NikitaSardesai/AERO3760-Space-Engineering-2/PCBlayout/README.txt

A rough layout of the pcbs physical location within the structure
