NikitaSardesai/AERO3760-Space-Engineering-2/PDR TeX/StructuralDesign.tex

%\section{Structural Design}
%The proposed one-unit satellite structure will be 3D printed using ABS plastic. This method was chosen in preference of an aluminium chassis primarily because of the ease of access of production.
