NikitaSardesai/AERO3760-Space-Engineering-2/PDR TeX/titlepage.tex

\begin{titlepage}

\thispagestyle{empty}
\begin{center}
\begin{minipage}{\linewidth}
    \centering
%University logo
    
    \par
    \vspace{1.2cm}
    {\textsc{School of Aerospace Mechanical and Mechatronic Engineering \\ \vspace{0.3cm}
            AERO3760: Space Engineering 2}}
   \vspace{0.7cm}
%Thesis title
	\hrule
    \vspace{1.5cm}
    {{\LARGE\roboto{ SnapSat Preliminary Design Report }\par}}

    \vspace{1.5cm}
    \hrule
    \vspace{1.3cm}
     {\large \textsc{21 August 2015}}
\vspace{1.3cm}
%Author's name
    \begin{table}[H]
        \centering
        %\caption{Team Member Details and Contributions}
        \vspace{0.2cm}
        \label{tab:maxturbulencealpha}
        {\renewcommand{\arraystretch}{1.7}%
            \begin{tabular}{|>{\centering\arraybackslash}m{6cm}|>{\centering\arraybackslash}m{9cm}|}
                \hline
                \textbf{Name and Email} & \textbf{Role and Responsibility} \\ \hline\hline
                James Allworth | 312073038  jall8741@uni.sydney.edu.au & \textit{Attitude Determination and Control System} \newline pointing budget  \\\hline
                Thomas Forbutt | 312101058  tfor8012@uni.sydney.edu.au & \textit{Communications and Data Handling} \newline link and data budgets - component selection \\\hline
                Oscar McNulty | 312106130  omcn3220@uni.sydney.edu.au & \textit{Structural Design and Development} \newline structural simulations and development \\\hline
                Penelope Player | 312106718  ppla7388@uni.sydney.edu.au & \textit{On-board Computer and Power System} \newline schematic and power budget - component selection - power system selection \\\hline
                Nikita Sardesai | 312088205  nsar2497@uni.sydney.edu.au & \textit{Thermal System Design and Payload} \newline mass budget thermal design - stemn page management \& report structure \\\hline
                \end{tabular} } 
        \end{table}
    
%    \vspace{1.8cm}
%    {\large\roboto{ Abstract}}
%    \vspace{0.4cm}
%    \justify
%    {\begin{spacing}{1.3} \lipsum[10] \end{spacing}\par}
\end{minipage}
\end{center}

\end{titlepage}
