NikitaSardesai/AERO3760-Space-Engineering-2/PDR TeX/Introduction.tex

\section{Introduction}
SnapSat is a design solution as a part of the AERO3760: Space Engineering 2 course at the University of Sydney. The project involves specific design specifications as set out by the course administrator and the CubeSat requirements~\cite{specification}. This report details the selected mission and preliminary design considerations. Satellite components will be purchased off the shelf, where financially viable. Otherwise, components will be made in-house. Over the course of the project development, components will be tested separately and a series of final testing will be conducted once assembly is completed. SnapSat will undergo vibration testing, vacuum testing, communications and power testing and the attitude determination and control system will be tested on an air-bearing table.
