NikitaSardesai/AERO3760-Space-Engineering-2/Presentations/SnapSat CDR Presentation.pptx

## SnapSat

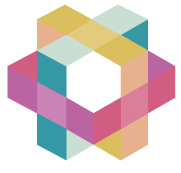
[picture p25: figure]

Critical Design Review
6th November 2015

Notes: Good Morning etc.

## Meet the Team

- James Allworth – Attitude Determination and Control
- Thomas Forbutt – Communications and On-board Data Handling
- Oscar McNulty – Structural Design and Development
- Penelope Player – On-board Computer and Power System
- Nikita Sardesai – Thermal Control and Payload

SnapSat Critical Design Presentation

Notes: First lets start by introducing the team. If you have any questions, feel free to ask.

## Our Mission

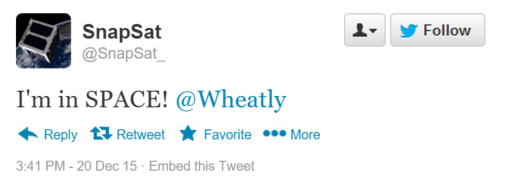
[picture p26: figure]

To bring space to YOU

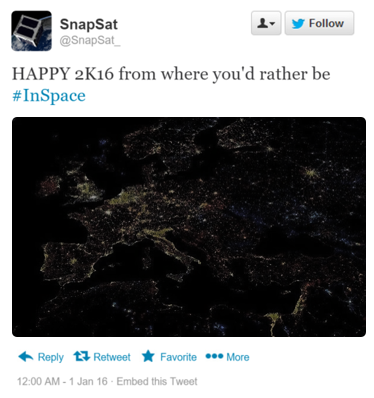
[picture p27: figure]
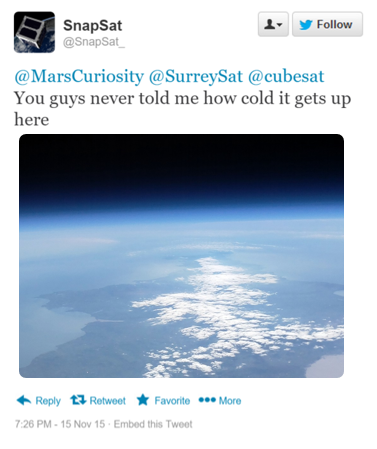
[picture p28: figure]

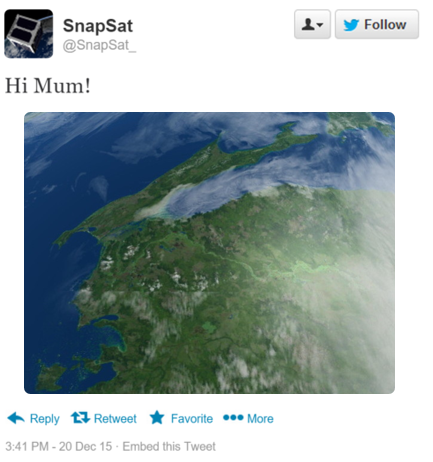
[picture p29: figure]

Notes: So what’s out mission? SnapSat is destined to be a satellite that is directly accessible to you!
SnapSat is a nano-satellite designed for outreach and space accessibility for educational bodies and the general public. In a sun-synchronous orbit at an altitude of 350km, SnapSat will be in the prime position of Earth observation. Users can send a message to the cubesat, which will take beautiful images of the Earth and tweet it to the world.
SnapSat will relay position data, so users are able to take photographs where they please. There is also scope for the development of a desktop/phone application for direct user connection to the satellite via groundstation.
Following the success the final build and launch, the team is hoping to lunch SnapSat on a sounding rocket - where it will stay in a LEO for about 3 months, taking beautiful photographs!

For example (These are hypothetical and not images taken with SnapSat. However, these are indicative of the quality of photos we are hoping to achieve):

SnapSat will relay position data, so users are able to take photographs where they please. There is also scope for the development of a desktop/phone application for direct user connection to the satellite via groundstation.

## Design Point

- 1U Cubesat
- $1000 budget
- 13 week timescale
- Design for balloon launch to 30km
- Communications: 5-node networking scheme

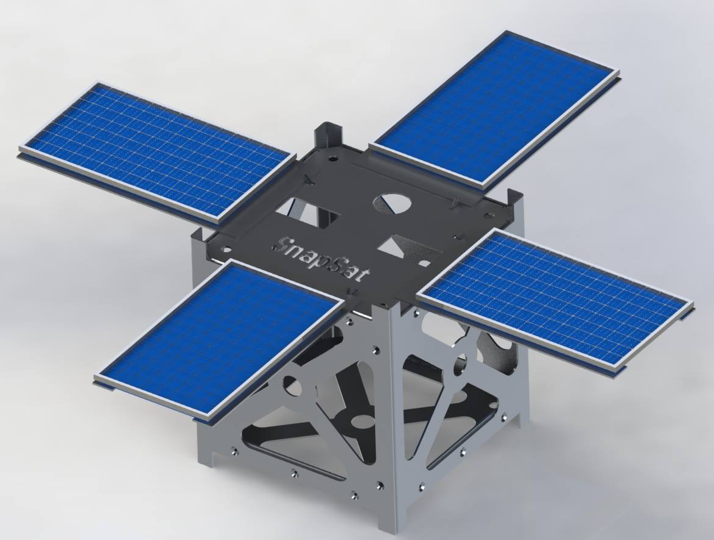
[picture p30: figure]

Figure 1 – Preliminary Design
(this has since been improved upon)

## Operation Overview

- Component Selection and Operation

## Component Selection

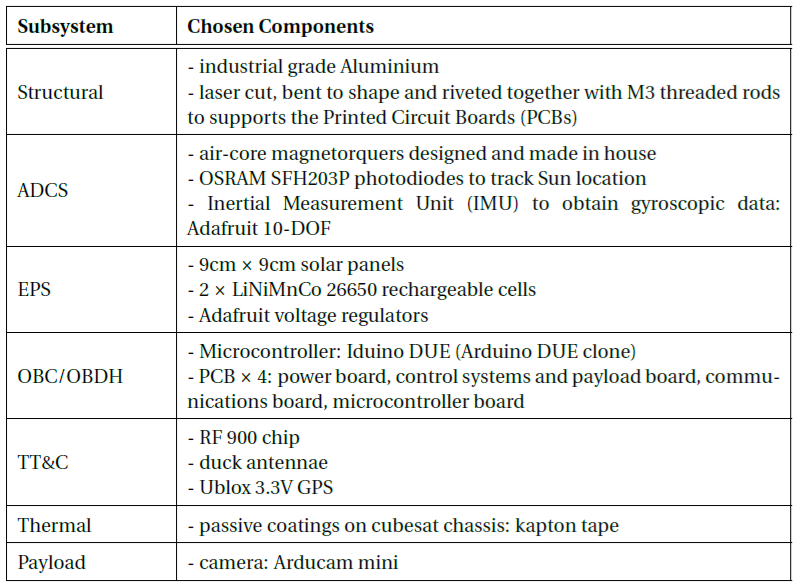
[picture p31: figure]

## System Interaction


## Structural Design

- Oscar McNulty

## Final Design

## FEA Test Methodology

- Natural Frequency
- Sinusoidal Sweep
- Random Frequency
- Quasi-Static

## Mass Budget

Subsystem | Component | Mass + Contingency | Fraction of total mass
Structural | Chassis – Laser cut Aluminium Solar Panels | 435 g | 47.6%
ADCS | Air core coils (in house) Osram photodiodes Adafruit 9DOF IMU | 180.2 g | 22%
EPS | Batteries & Power bus | 122 g | 14.9%
OBC / OBDH | Arduino DUE board Memory storage | 31.2 g | 3.8%
TT&C | Antennae VHF/UHF receivers/transmitters | 84 g | 10.3%
Thermal | Heat taping, Kapton tape Multi-layer insulation | 4.8 g | 0.6%
Payload | TTL Camera | 25 g | 3.1%
Integration | Wires, bolts and cables | 9.5 g | 1.2%

## Mass Balance & Total Weight

Subsystem | Total Weight | Distance From Centroid | Inertial Contibution
Structural
ADCS
EPS
OBC / OBDH
TT&C
Thermal
Payload
Integration

## Attitude Determination and Control (ADCS)

- James Allworth

## Attitude Determination

- GPS
- IMU
- Sun Sensors

## Attitude Control

- GPS
- IMU
- Sun Sensors
- Magnetorquers
- Control System

## Magnetorquer Design

## Control System Design

## Electrical Power System (EPS)

- Penelope Player

## System Specifications

- Components
- Charging Circuit
- Voltage Rails
- Battery Lifetime

## Power Budget

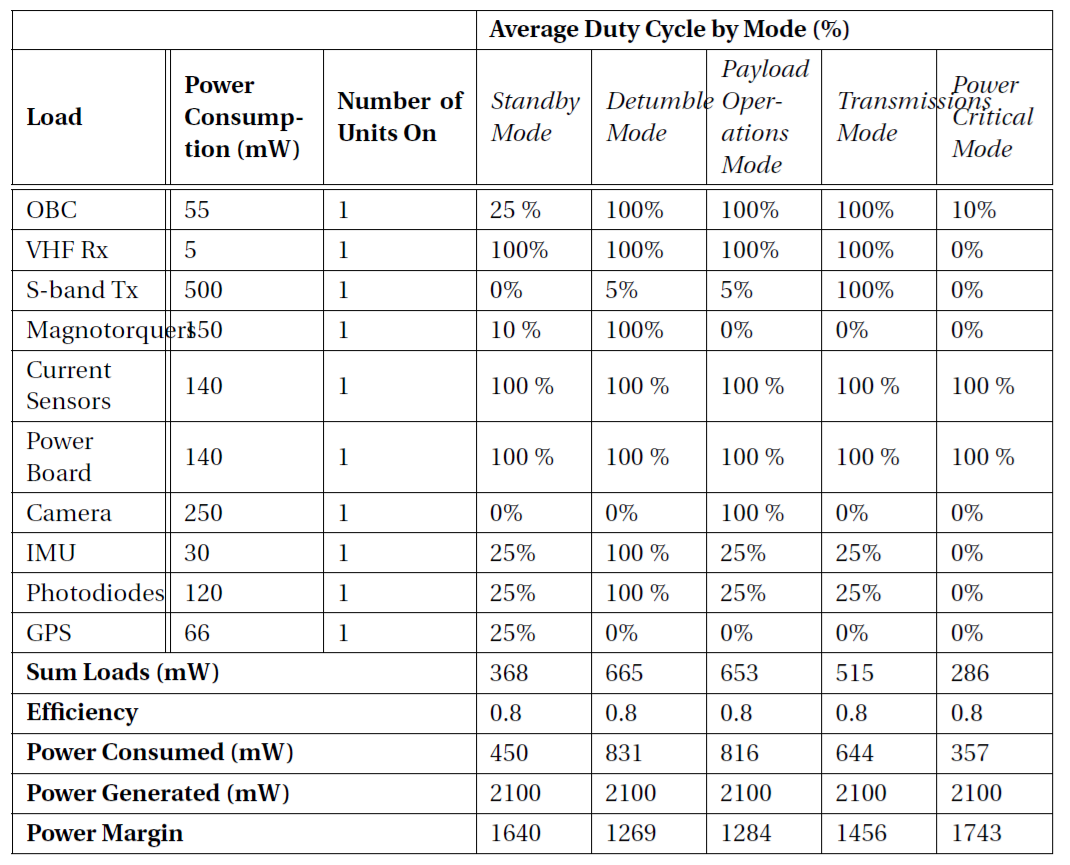
[picture p32: figure]

## On-Board Computer and Data Handling (OBC/DH)

- Penelope Player

## System Interactions

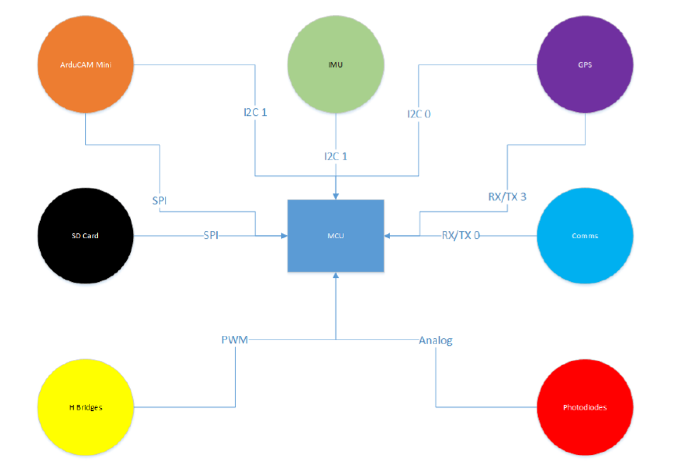
[picture p33: figure]

## Communications

- Thomas Forbutt

## Components and Specifications

- details

## Five-Node Network Setup

- details

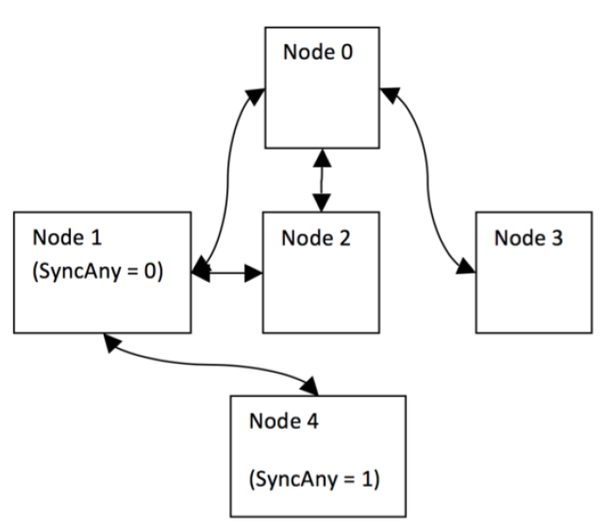
[picture p34: figure]

## Thermal Control

- Nikita Sardesai

Note to snapsat: (this section is a bit too long – I will cut it down!)

## Space Thermal Dynamics

- Model specified for 3 month, 350km orbit
- Simplified mass: system dissipating heat to boundary exposed to space
- General governing equation

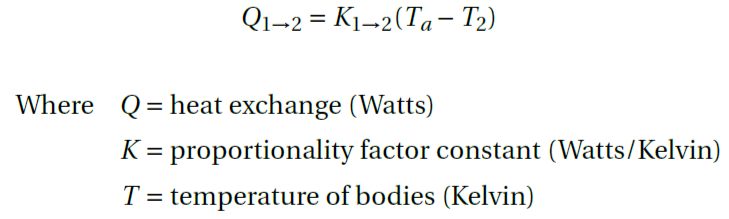
[picture p35: figure]

Notes: Go though component selection

Note: we were able to achieve such a high mass budget since expesive, space rated and optimised componenet were selected.

## Space Thermal Environment

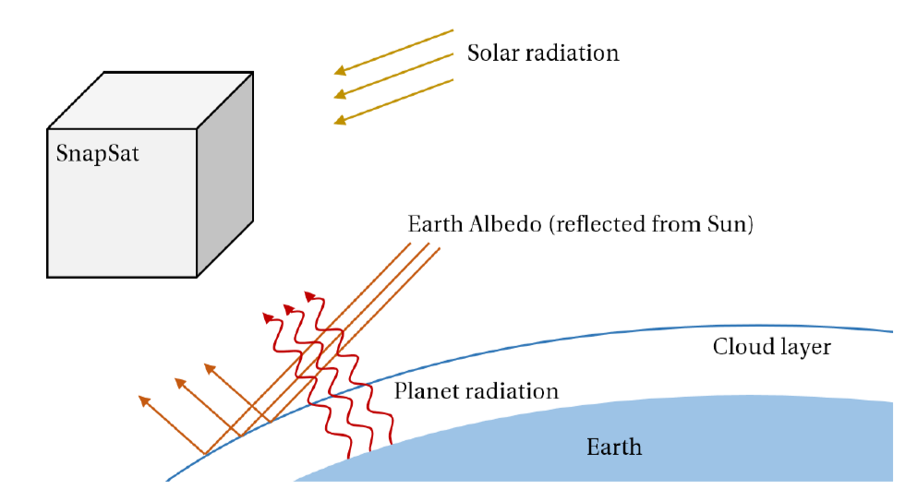
[picture p36: figure]

Notes: Go though component selection

Note: we were able to achieve such a high mass budget since expesive, space rated and optimised componenet were selected.

## Heat Transfer Modes

- Heat flux relates to a change in temperature as
- Three modes:
  - Conduction
  - Convection (not relevant)
  - Radiation

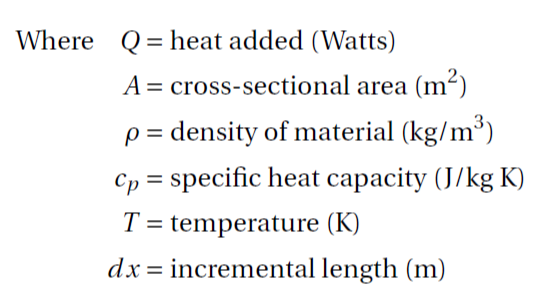
[picture p37: figure]

Notes: Go though component selection

Note: we were able to achieve such a high mass budget since expesive, space rated and optimised componenet were selected.

## Total Incoming Radiation

- Specification: sun-synchronous, 66% of orbit time spent in the sun, 98° inclination
  - Simulated orbit was rotated 45° about the z Earth-body axis and 8° about the y Earth-body axis

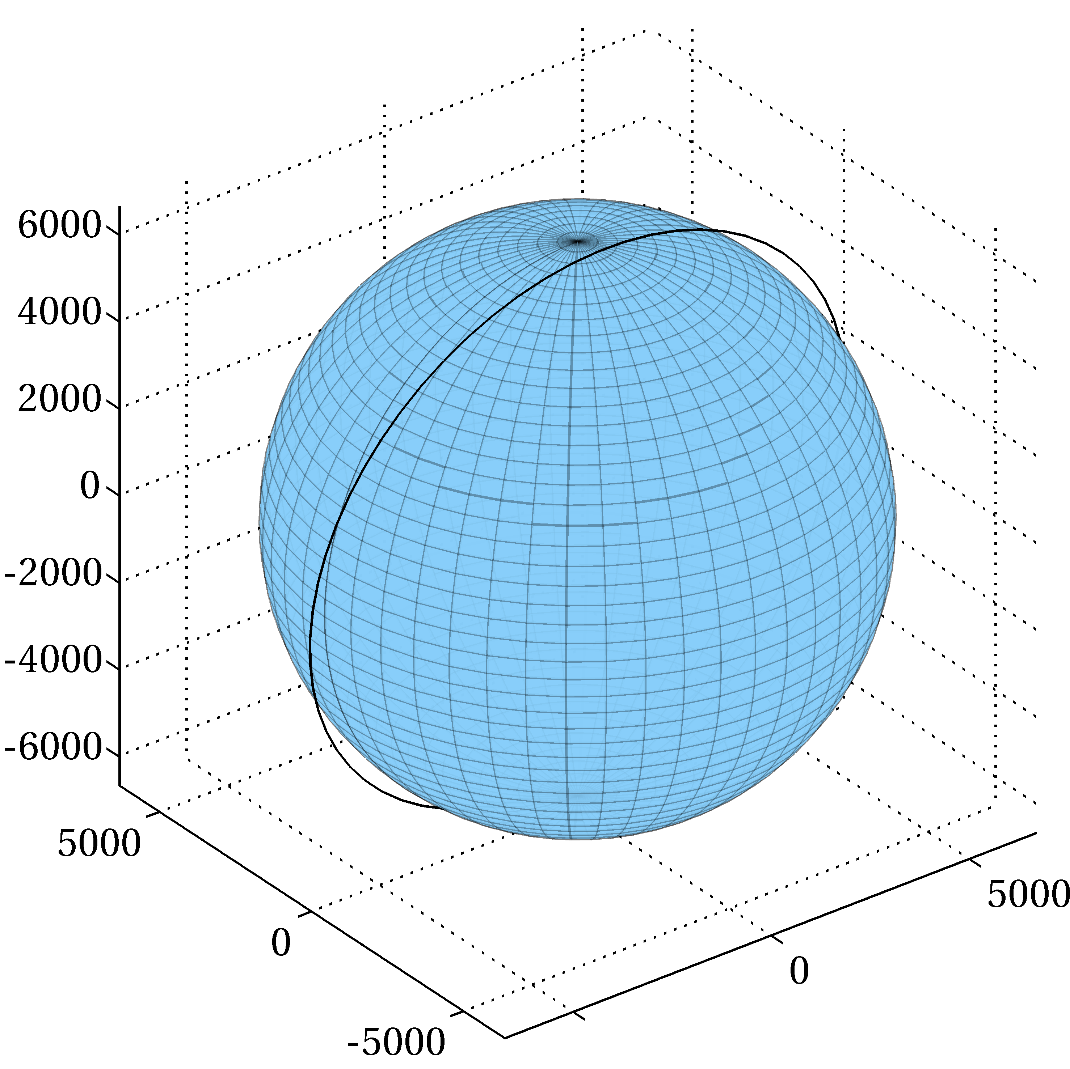
[picture p38: figure]

Notes: Go though component selection

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

## Total Incoming Radiation

- Considering the external radiative fluxes
  - Albedo (constant = 0.3), Solar (absorptivity = 0.8), Earth-IR. This is NOT panel-by-panel

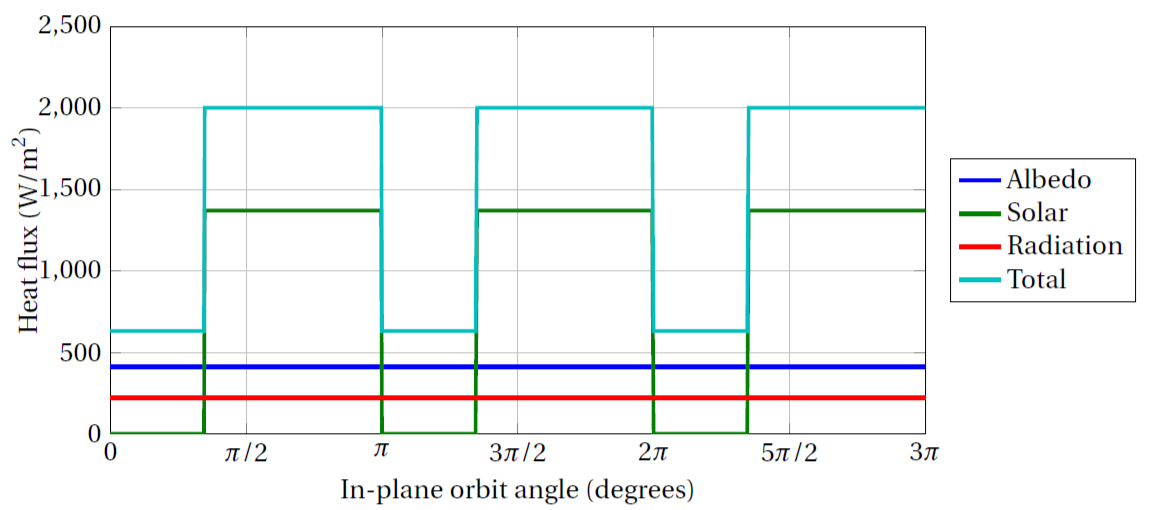
[picture p39: figure]

Notes: Go though component selection

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

## Panel Numbering

- As a guide for the following slides

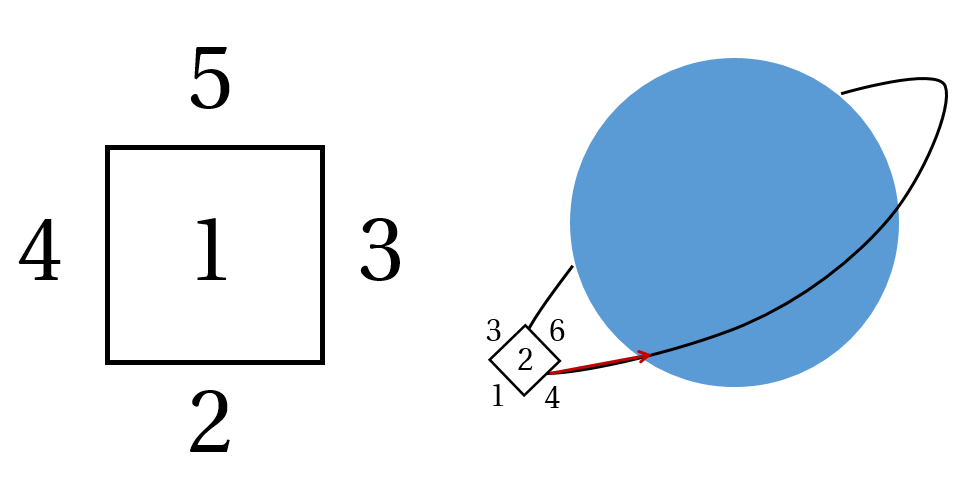
[picture p40: figure]

Notes: Go though component selection

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

## Solar Radiation Per Panel

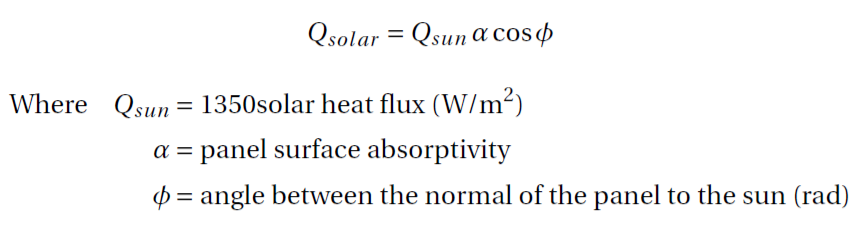
[picture p41: figure]
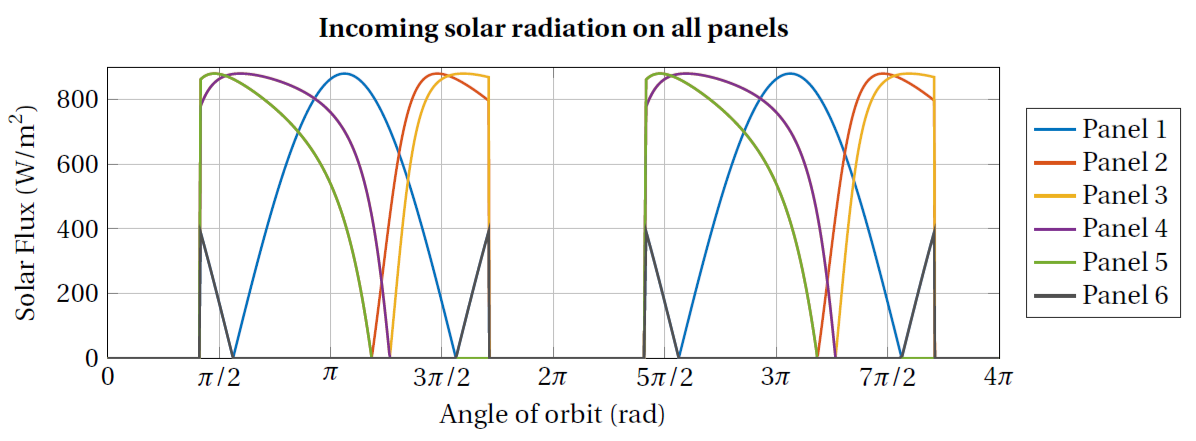
[picture p42: figure]

Notes: Go though component selection

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

## Earth Infrared Radiation

- Constant value for each panel throughout orbit
- View Factor: projected visible area given by

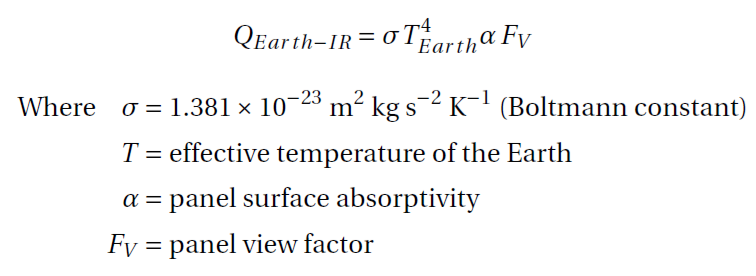
[picture p43: figure]
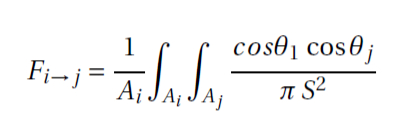
[picture p44: figure]

Notes: Go though component selection

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

## Earth Albedo

- Albedo factor varies depending on the case considered

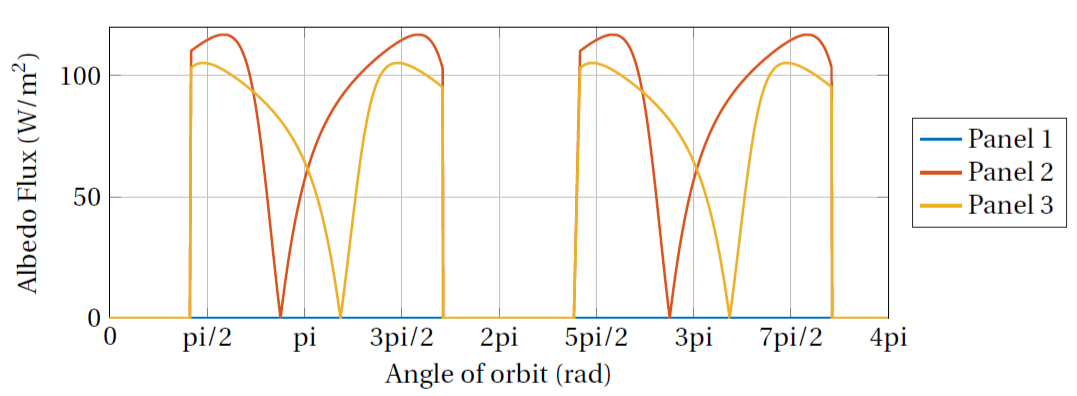
[picture p45: figure]
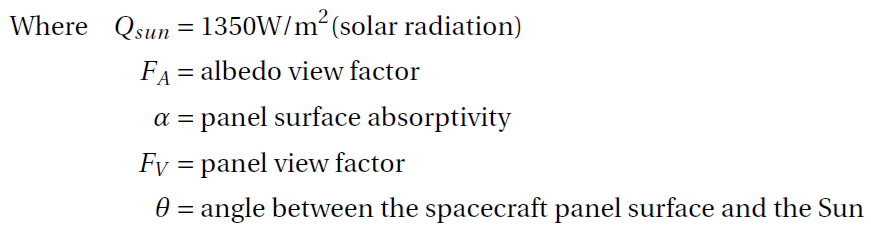
[picture p46: figure]

Notes: Go though component selection

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

## Total Panel Incoming Radiation

- Shown here for Panel 2, but computed for all panels

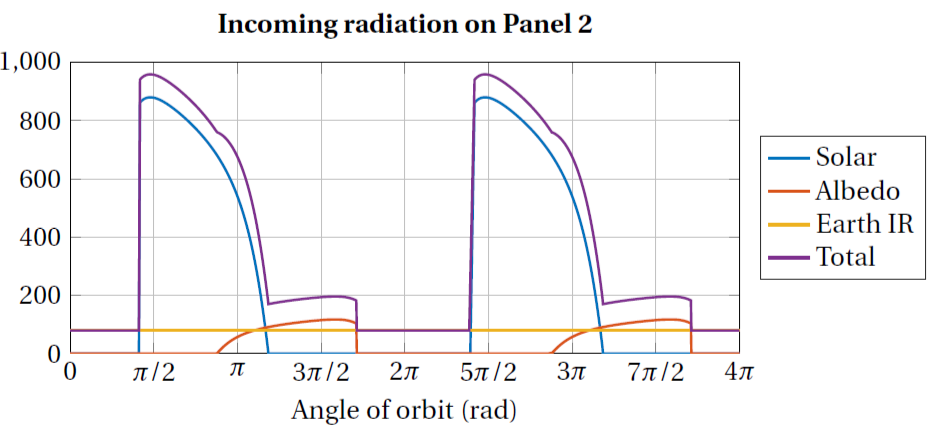
[picture p47: figure]

Notes: Go though component selection

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

## Temperature Change Per Panel

- To be completed

Notes: Go though component selection

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

## Concluding Remarks

## Lessons Learned and Future Work

- To be completed

Notes: Go though component selection

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

## SnapSat

Critical Design Review
stemn.com/projects/cubesat-alpha
