NikitaSardesai/AERO3760-Space-Engineering-2/PDR TeX/main.pdf

### 0.1 Gantt Chart

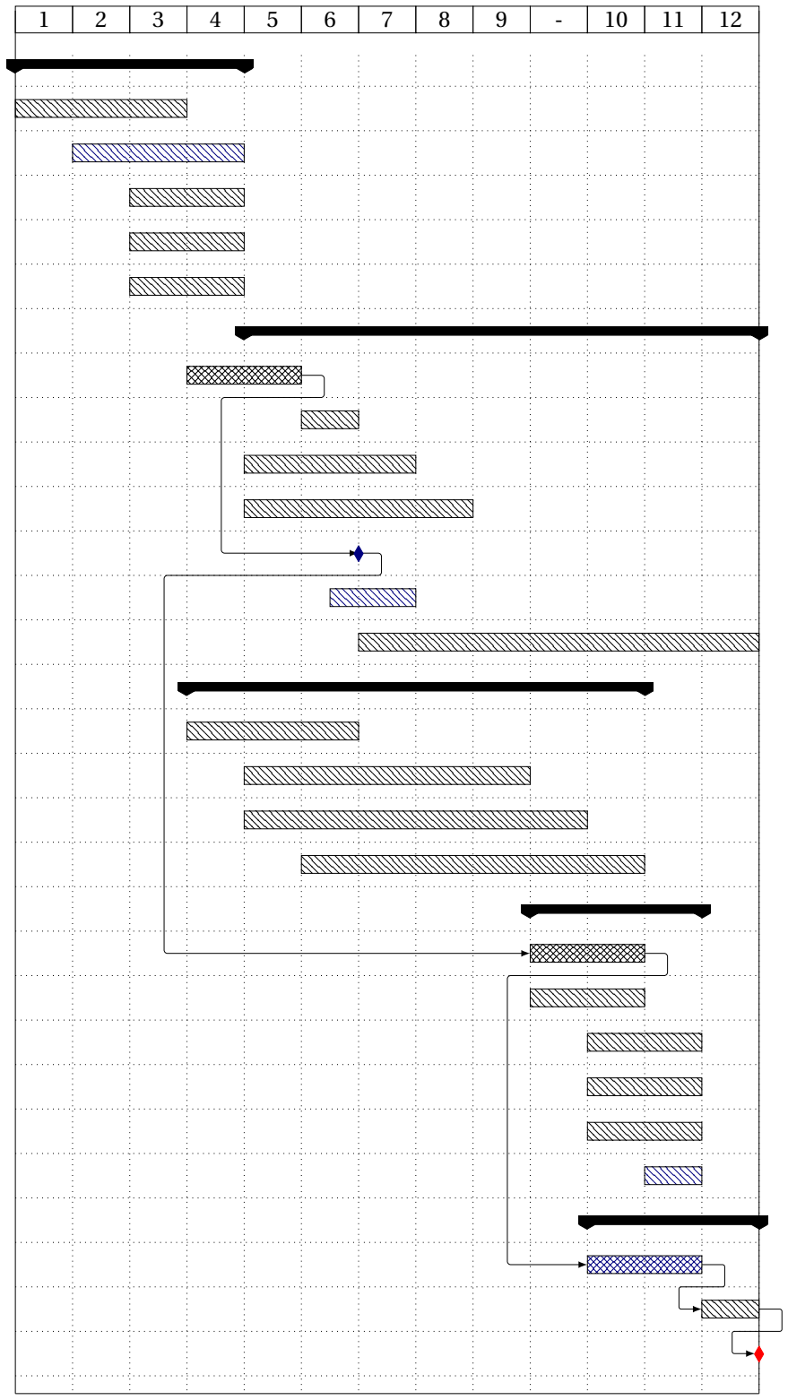
[picture p54: figure]

Preliminary Design

Component Selection

Structural Design

Link Budgets

Mass Budgets

Power Budgets

Critical Design

Component Reselection

Budget Reevaluation

PCB Design and Order

Thermal Design

Order Componenets

Finalise/Send Structure

Report Compilation

Code Development

Environment Model

Simulink Model

Arduino

Interface

Componenet Testing

Receive Components

Thermal System Testing

ADCS Testing

Link Testing

Solar Cell Testing

Vibration and Intgeration

Launch Preparation

Assembly

Final Testing

Balloon Launch

SnapSat PDR Summary Issue 1 | 1
