NikitaSardesai/AERO3760-Space-Engineering-2/PDR TeX/ProjectPlans.tex

%\section{Project Plans and Schedule}
%A general schedule for the SnapSat project is outlined below. A Gantt chart is provided on the following page.
%\begin{table}[H]
%    \centering
%    \caption{SnapSat Project Schedule}
%    \vspace{0.15cm}
%%    \label{tab:designoverview}
%    {\renewcommand{\arraystretch}{1.2}%
%        \begin{tabular}{|>{\arraybackslash}m{4cm}|>{\arraybackslash}m{4cm}|>{\arraybackslash}m{3cm}|>{\arraybackslash}m{3cm}|}
%            \hline
%            \textbf{Major Task} & \textbf{Responsibility} & {\bf Start Date} & {\bf End Date} \\ \hline\hline
%            Structural \newline Development & Oscar McNulty & 03/08/2015 & 21/08/2015\\\hline
%            Preliminary \newline Design Report & Nikita Sardesai & 03/08/2015 & 23/08/2015\\\hline
%           Component Selection & All members & 03/10/2015 & 17/10/2015\\\hline
%            Link Budgets & Thomas Forbutt & 10/08/2015 & 23/08/2015 \\\hline
%			Mass Budgets & Nikita Sardesai & 10/08/2015 & 23/08/2015 \\\hline           
%          Power Budgets & Penelope Player & 10/08/2015 & 23/08/2015 \\\hline
%           Pointing Budget & James Allworth & 10/08/2015 & 23/08/2015\\\hline
%           Component \newline Reselection	& All members & 21/08/2015 & 28/08/2015\\\hline
%            PCB Design & Penelope Player & 23/08/2015 & 11/09/2015 \\\hline
%           Thermal Design & Nikita Sardesai & 23/08/2015 & 18/09/2015 \\\hline
%            Code Development & All members & 16/08/2015 & 09/09/2015\\\hline
%            Environment Model & Nikita Sardesai & 17/08/2015 & 04/09/2015\\\hline
%           Simulink Model & James Allworth & 24/08/2015 & 25/09/2015\\\hline
%           Arduino Code & Thomas Forbutt & 24/08/2015 & 02/10/2015\\\hline
%            Interface & Penelope Player & 07/09/2015 & 09/09/2015\\\hline
%            Report Compilation & All members & 07/09/2015 & 23/10/2015\\\hline
%            Component Testing & All members & 25/09/2015 & 16/10/2015\\\hline
%            Thermal Systems \newline Testing & Nikita Sardesai & 28/09/2015 & 09/10/2015\\\hline
%            ADCS Systems Testing & James Allworth & 05/09/2015 & 16/10/2015\\\hline
%            Link Systems Testing & Thomas Forbutt & 05/09/2015 & 16/10/2015\\\hline
%            Solar Cell Testing & Oscar McNulty & 05/09/2015 & 16/10/2015\\\hline
%            Final Assembly & Oscar McNulty & 05/10/2015 & 16/10/2015 \\\hline
%            Vibration \& \newline Integration Testing & Penelope Player & 12/10/2015 & 16/10/2015 \\\hline
%            Final Testing & All members & 16/10/2015& 23/10/2015\\\hline
%           Balloon Launch & Available members & 24/10/2015 & 25/10/2015\\\hline
%             
%        \end{tabular} } 
%    \end{table}

\subsection{Gantt Chart}
\begin{gantt}[xunitlength=0.9cm,drawledgerline=true]{31}{13}
  \begin{ganttitle}
     \numtitle{1}{1}{9}{1}
     \titleelement{-}{1}
     \numtitle{10}{1}{12}{1}
  \end{ganttitle}
        
    \ganttgroup{Preliminary Design\qquad\quad}{0}{4}
    \ganttbar{Component Selection\qquad\quad}{0}{3}
    \ganttbar[color=NavyBlue]{Structural Design\qquad\quad}{1}{3}
    \ganttbar{Link Budgets\qquad\quad}{2}{2}
    \ganttbar{Mass Budgets\qquad\quad}{2}{2}
    \ganttbar{Power Budgets\qquad\quad}{2}{2}
    
    \ganttgroup{Critical Design\qquad\quad}{4}{9}
    \ganttbar[pattern=crosshatch]{Component Reselection\qquad\quad}{3}{2}
    \ganttbar{Budget Reevaluation\qquad\quad}{5}{1}
    \ganttbar{PCB Design and Order\qquad\quad}{4}{3}
    \ganttbar{Thermal Design\qquad\quad}{4}{4}
    \ganttmilestone[color=NavyBlue]{Order Componenets\qquad\quad}{6}
    \ganttbar[color=NavyBlue]{Finalise/Send Structure\qquad\quad}{5.5}{1.5}
    \ganttbar{Report Compilation\qquad\quad}{6}{7}
    
    \ganttgroup{Code Development\qquad\quad}{3}{8}
    \ganttbar{Environment Model\qquad\quad}{3}{3}
    \ganttbar{Simulink Model\qquad\quad}{4}{5}
    \ganttbar{Arduino\qquad\quad}{4}{6}
    \ganttbar{Interface\qquad\quad}{5}{6}

    \ganttgroup{Componenet Testing\qquad\quad}{9}{3}
    \ganttbar[pattern=crosshatch]{Receive Components\qquad\quad}{9}{2}
    \ganttbar{Thermal System Testing\qquad\quad}{9}{2}
    \ganttbar{ADCS Testing\qquad\quad}{10}{2}
    \ganttbar{Link Testing\qquad\quad}{10}{2}
    \ganttbar{Solar Cell Testing\qquad\quad}{10}{2}
    \ganttbar[color=NavyBlue]{Vibration and Intgeration\qquad\quad}{11}{1}
    
    \ganttgroup{Launch Preparation\qquad\quad}{10}{3}
    \ganttbar[color=NavyBlue,pattern=crosshatch]{Assembly\qquad\quad}{10}{2}
    \ganttbarcon{Final Testing\qquad\quad}{12}{1}
    \ganttmilestonecon[color=red]{Balloon Launch\qquad\quad}{13}
    
%    \ganttcon{11}{21}{10}{28}
\draw[-latex,rounded corners=1.5pt] (5\ganttunitlength,-8+0.1 + 0.2) -- (5\ganttunitlength+0.4*\ganttunitlength,-8+0.1+0.2) -- (5\ganttunitlength+0.4*\ganttunitlength,-8-0.4+0.2) -- (5\ganttunitlength-1.4*\ganttunitlength,-8-0.4+0.2) -- (5\ganttunitlength-1.4*\ganttunitlength,-12+0.1+0.2) -- (6\ganttunitlength,-12+0.1+0.2);

\draw[-latex,rounded corners=1.5pt] (6\ganttunitlength,-12+0.1 + 0.2) -- (6\ganttunitlength+0.4*\ganttunitlength,-12+0.1+0.2) -- (6\ganttunitlength+0.4*\ganttunitlength,-12-0.4+0.2) -- (6\ganttunitlength-3.4*\ganttunitlength,-12-0.4+0.2) -- (6\ganttunitlength-3.4*\ganttunitlength,-21+0.1+0.2) -- (9\ganttunitlength,-21+0.1+0.2);
    
\draw[-latex,rounded corners=1.5pt] (11\ganttunitlength,-21+0.1 + 0.2) -- (11\ganttunitlength+0.4*\ganttunitlength,-21+0.1+0.2) -- (11\ganttunitlength+0.4*\ganttunitlength,-21-0.4+0.2) -- (11\ganttunitlength-2.4*\ganttunitlength,-21-0.4+0.2) -- (11\ganttunitlength-2.4*\ganttunitlength,-28+0.1+0.2) -- (10\ganttunitlength,-28+0.1+0.2);

\end{gantt}
