NikitaSardesai/AERO3760-Space-Engineering-2/6061/render.JPG

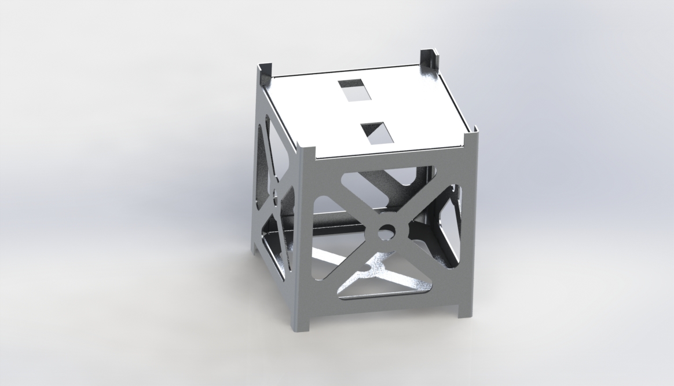
6061/render.JPG
