NikitaSardesai/AERO3760-Space-Engineering-2/6061/render_holes.JPG

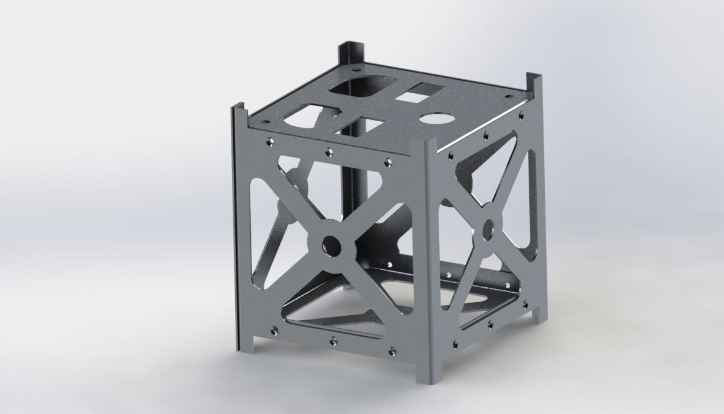
6061/render_holes.JPG
