NikitaSardesai/AERO3760-Space-Engineering-2/CDRTeX/figures/arducam.PNG

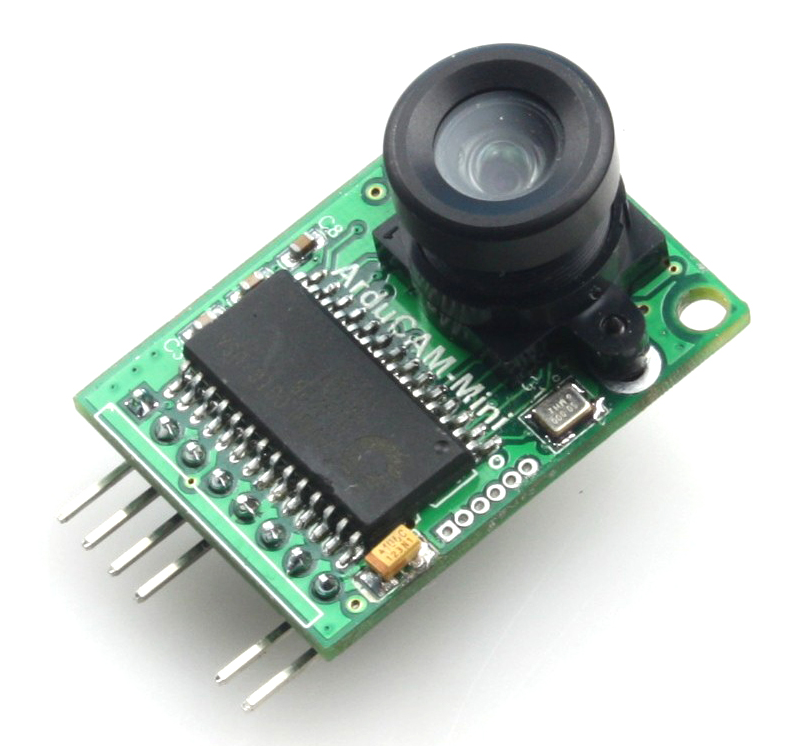
CDRTeX/figures/arducam.PNG
