NikitaSardesai/AERO3760-Space-Engineering-2/CDRTeX/figures/eaglepmu.PNG

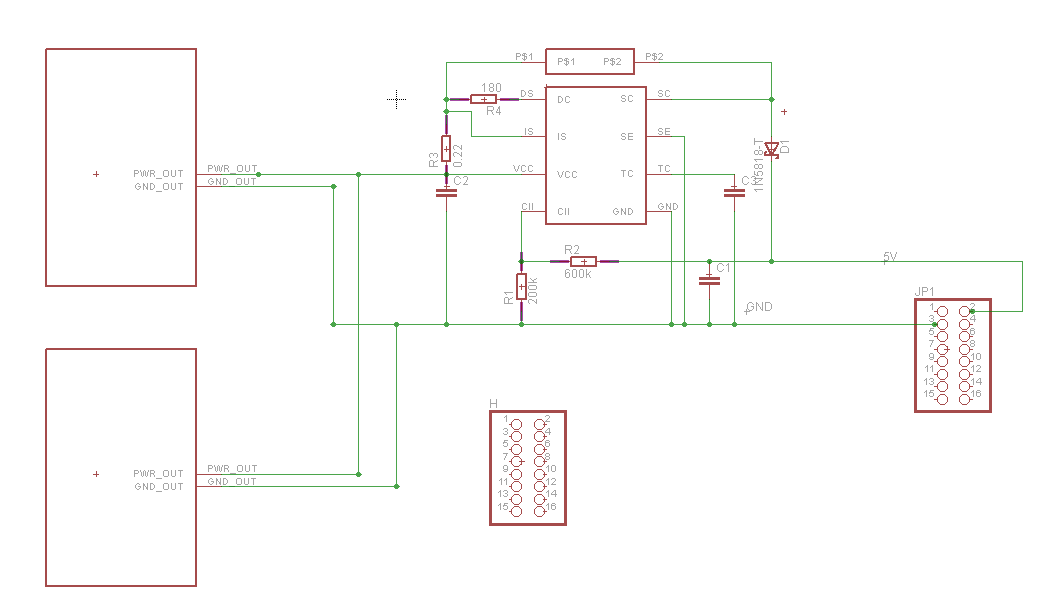
CDRTeX/figures/eaglepmu.PNG
