NikitaSardesai/AERO3760-Space-Engineering-2/CDRTeX/figures/epsloc.PNG

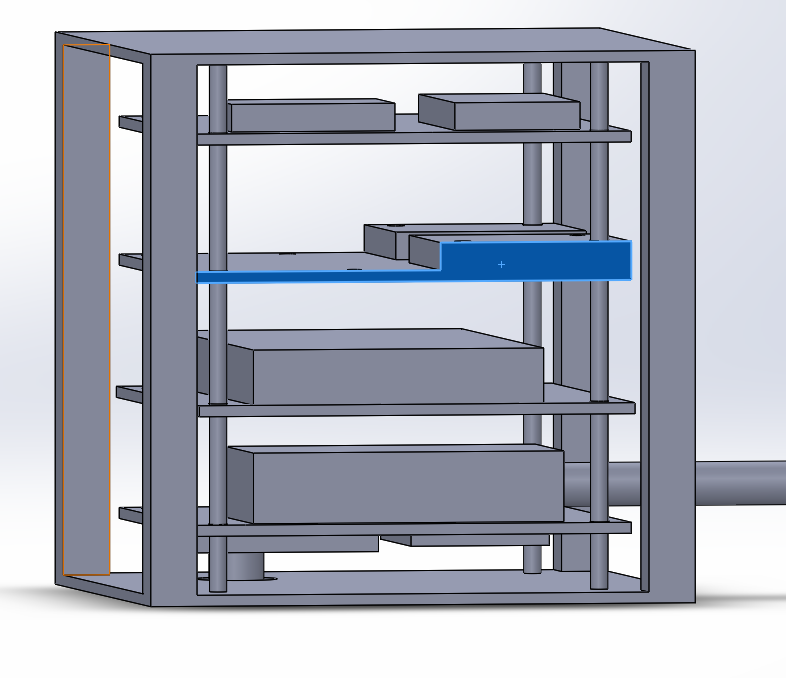
CDRTeX/figures/epsloc.PNG
