NikitaSardesai/AERO3760-Space-Engineering-2/CDRTeX/figures/epspcb.png

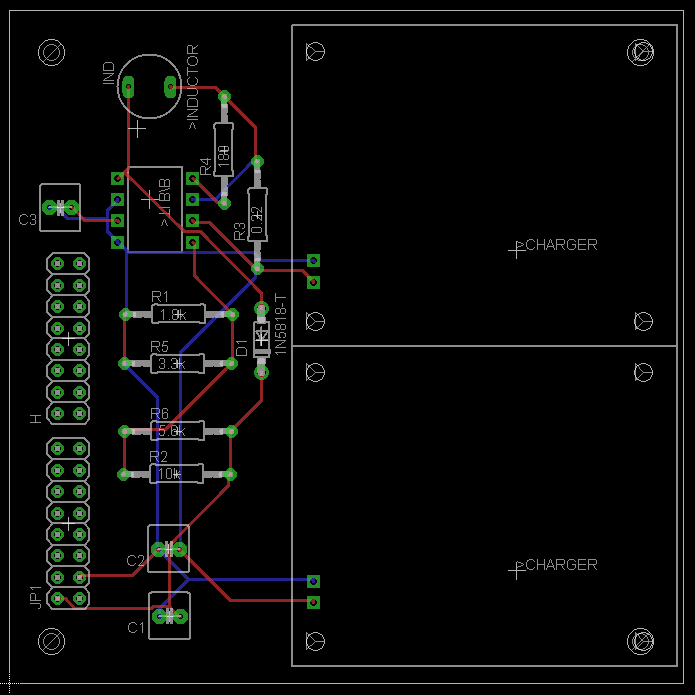
CDRTeX/figures/epspcb.png
