NikitaSardesai/AERO3760-Space-Engineering-2/CDRTeX/figures/highlighted.PNG

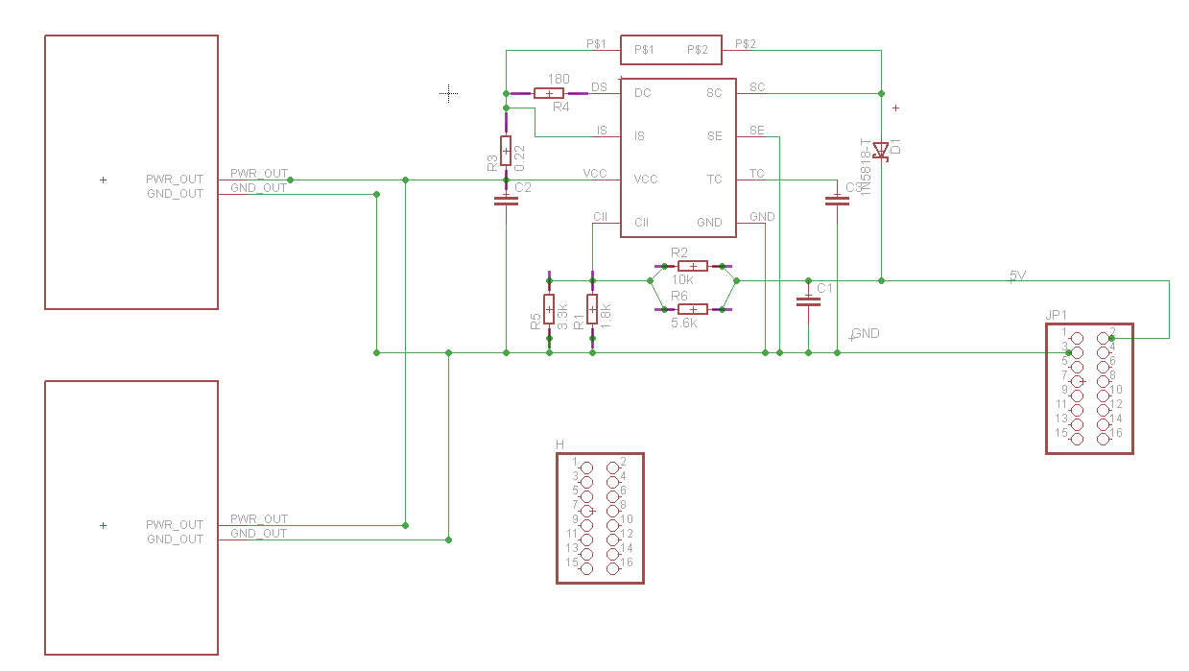
CDRTeX/figures/highlighted.PNG
