NikitaSardesai/AERO3760-Space-Engineering-2/CDRTeX/figures/incoming.PNG

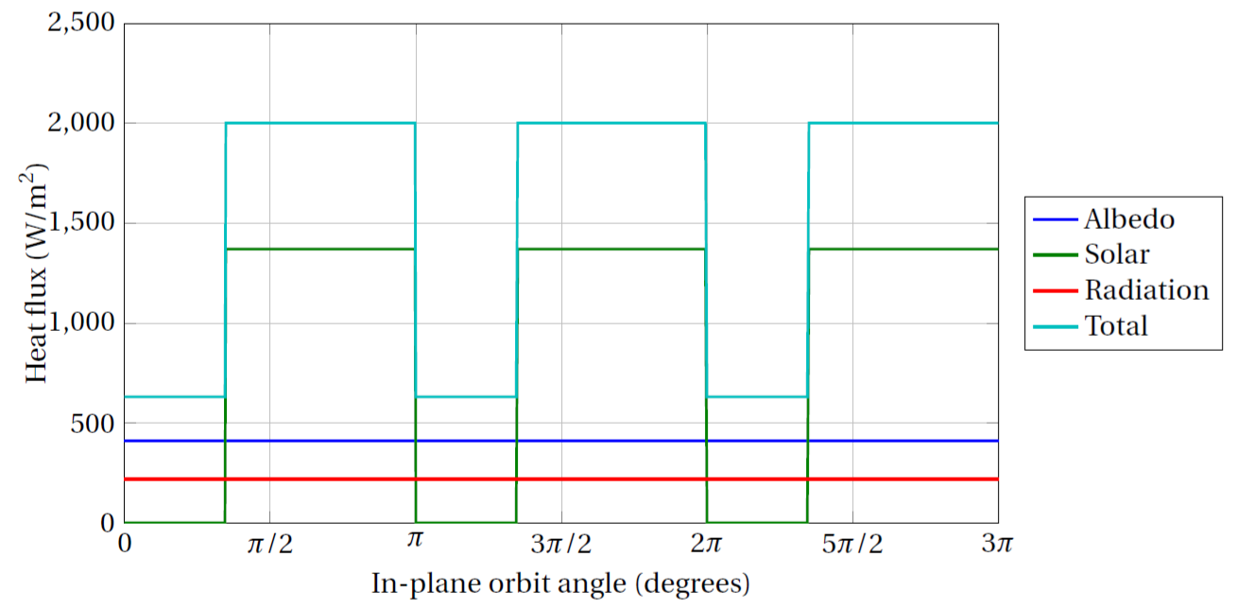
CDRTeX/figures/incoming.PNG
