NikitaSardesai/AERO3760-Space-Engineering-2/CDRTeX/figures/mcucon.png

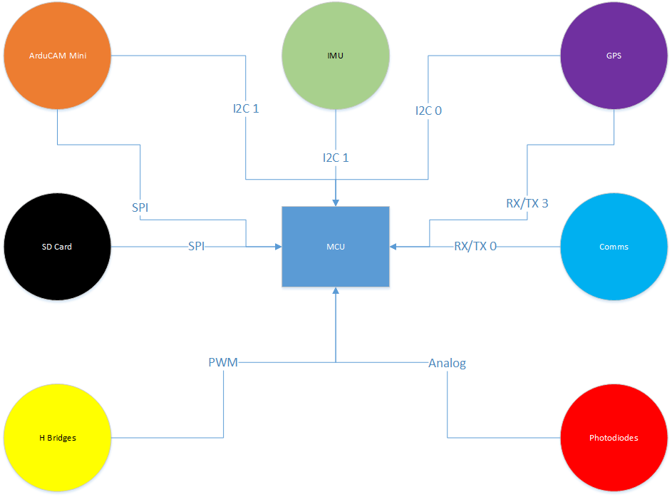
CDRTeX/figures/mcucon.png
