NikitaSardesai/AERO3760-Space-Engineering-2/CDRTeX/figures/panelincoming.PNG

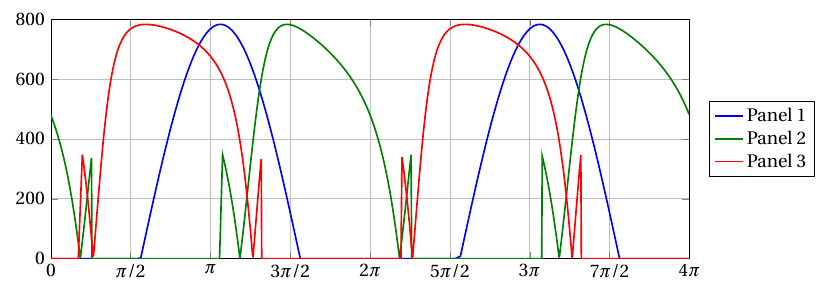
CDRTeX/figures/panelincoming.PNG
