NikitaSardesai/AERO3760-Space-Engineering-2/CDRTeX/figures/panelincoming_fixed.PNG

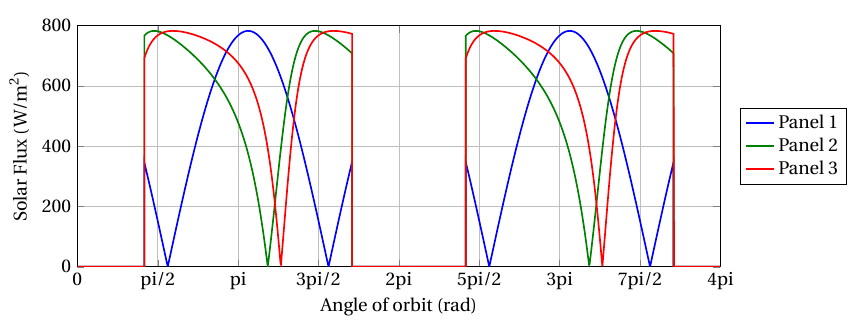
CDRTeX/figures/panelincoming_fixed.PNG
