NikitaSardesai/AERO3760-Space-Engineering-2/CDRTeX/figures/pmu1.png

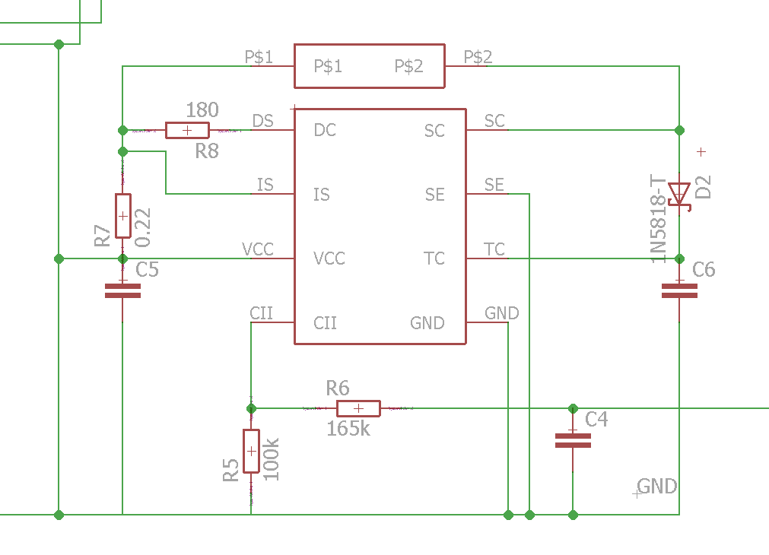
CDRTeX/figures/pmu1.png
