NikitaSardesai/AERO3760-Space-Engineering-2/CDRTeX/figures/pmu2.png

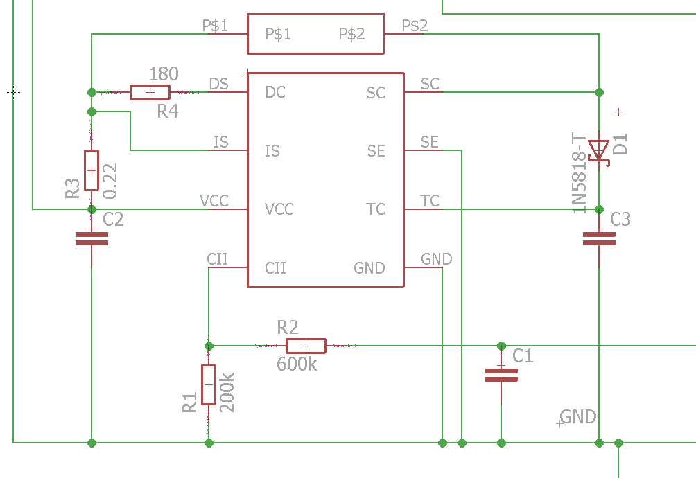
CDRTeX/figures/pmu2.png
