NikitaSardesai/AERO3760-Space-Engineering-2/CDRTeX/figures/pmu3.png

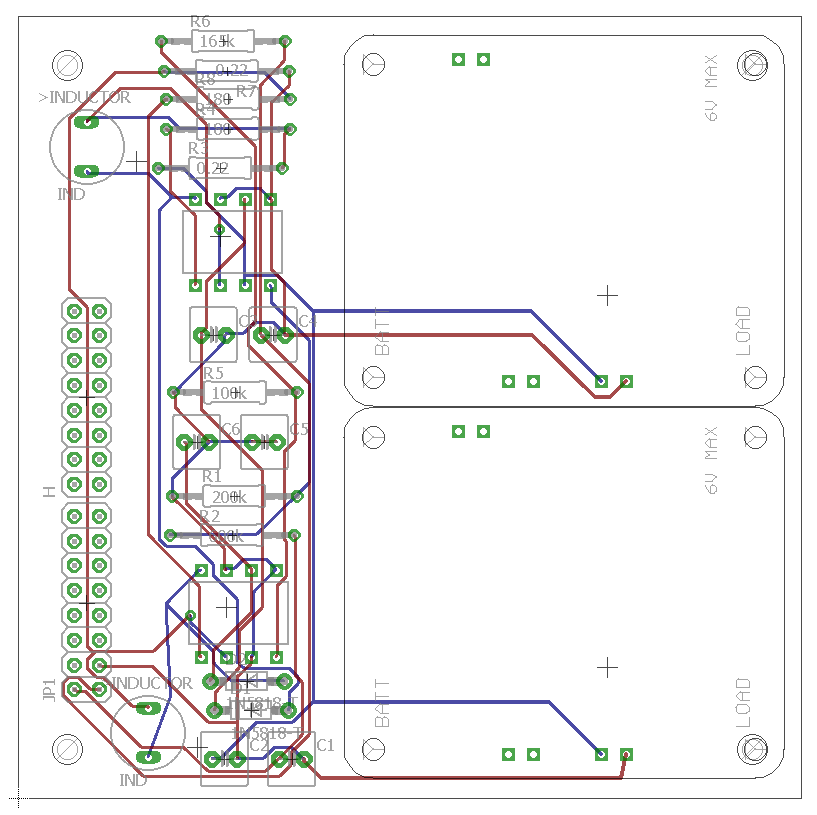
CDRTeX/figures/pmu3.png
