NikitaSardesai/AERO3760-Space-Engineering-2/CDRTeX/figures/sdcard.PNG

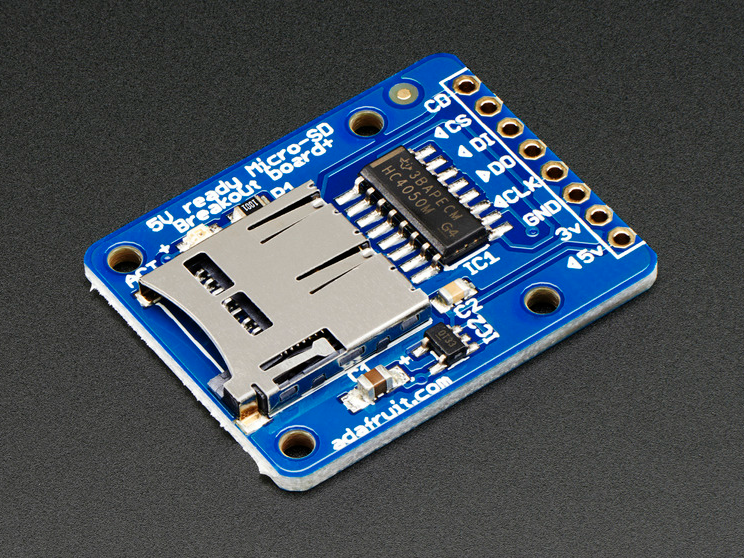
CDRTeX/figures/sdcard.PNG
