NikitaSardesai/AERO3760-Space-Engineering-2/CDRTeX/figures/stepdown.PNG

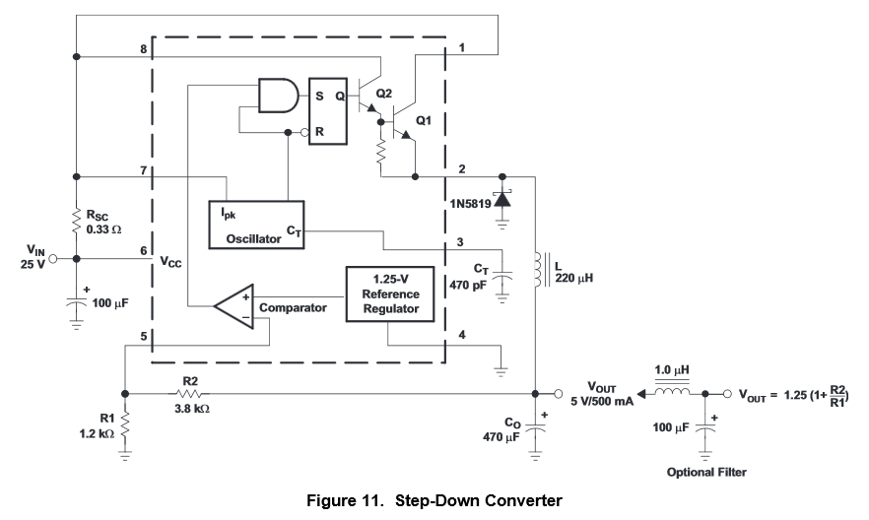
CDRTeX/figures/stepdown.PNG
