NikitaSardesai/AERO3760-Space-Engineering-2/CDRTeX/figures/stepup.PNG

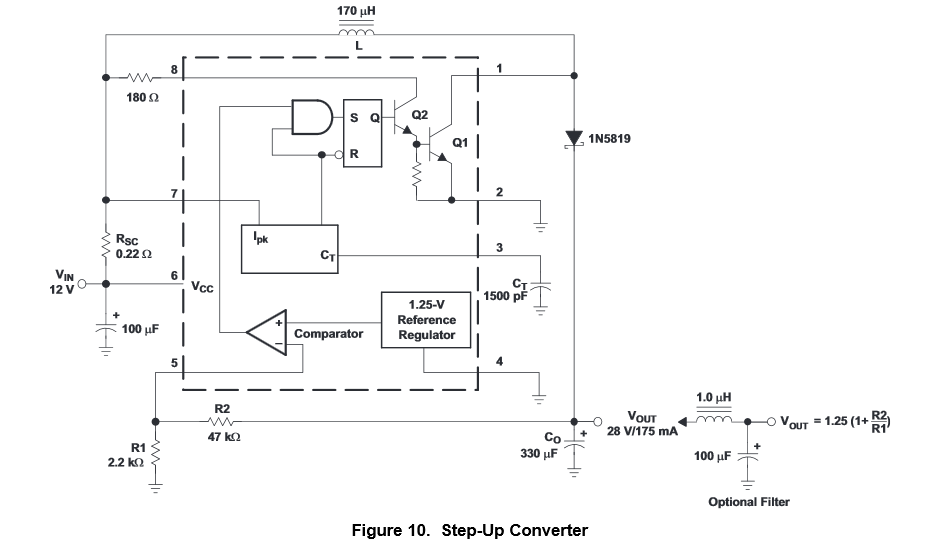
CDRTeX/figures/stepup.PNG
