NikitaSardesai/AERO3760-Space-Engineering-2/CDRTeX/figures/thermallong.png

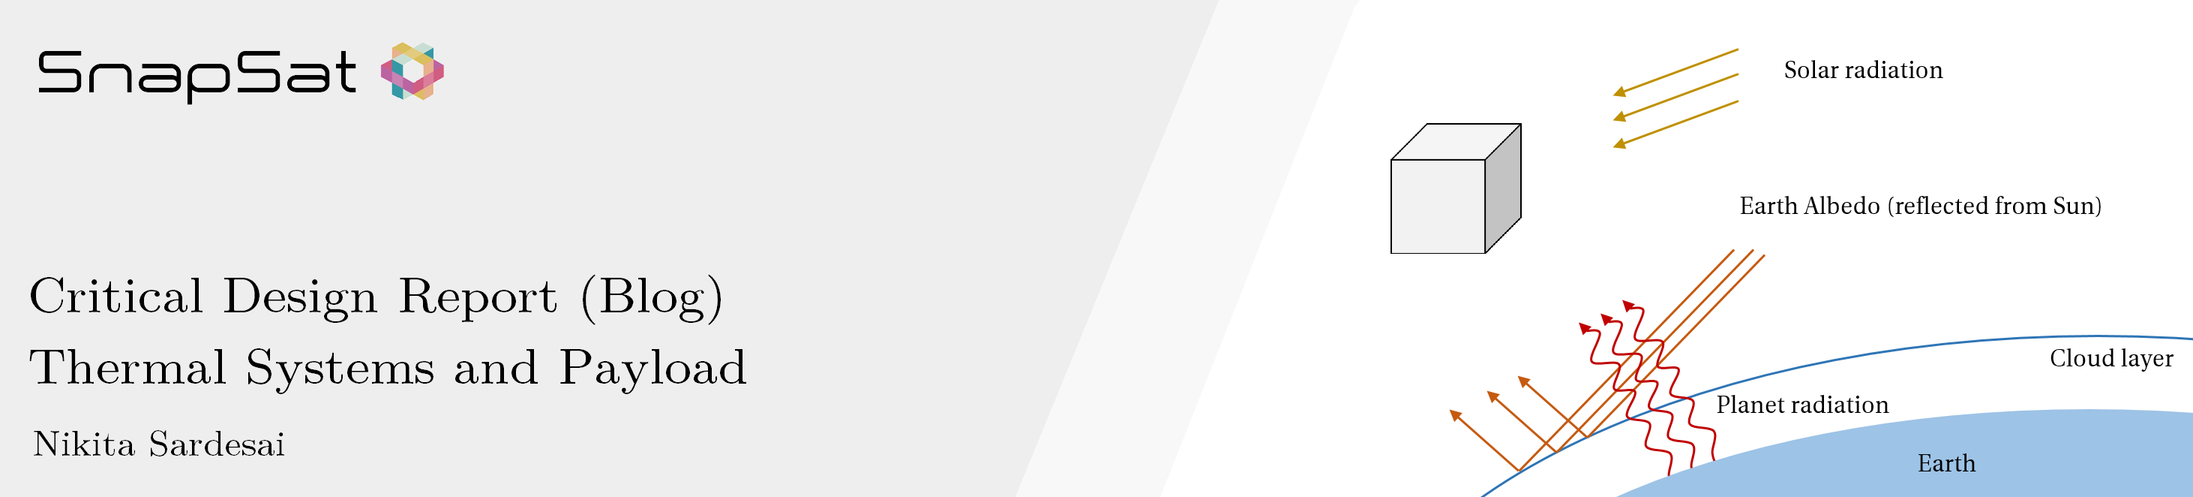
CDRTeX/figures/thermallong.png
