NikitaSardesai/AERO3760-Space-Engineering-2/CDRTeX/figures/thermaloverview.png

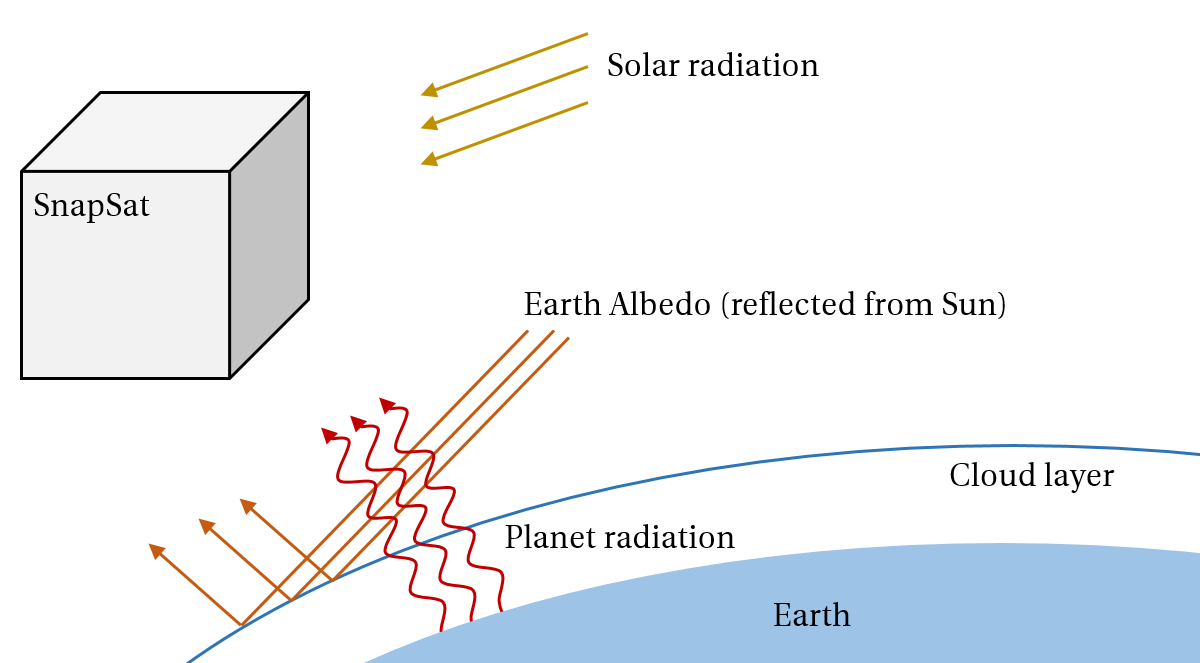
CDRTeX/figures/thermaloverview.png
