NikitaSardesai/AERO3760-Space-Engineering-2/CDRTeX/figures/ticalcs.PNG

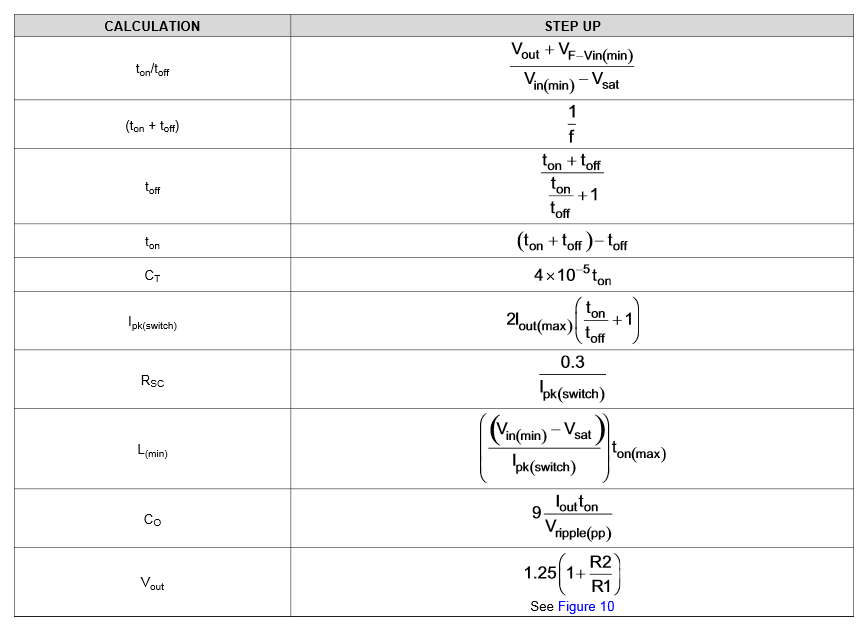
CDRTeX/figures/ticalcs.PNG
