NikitaSardesai/AERO3760-Space-Engineering-2/Code/ZZ_extras/example pictures from Arducam/10.JPG

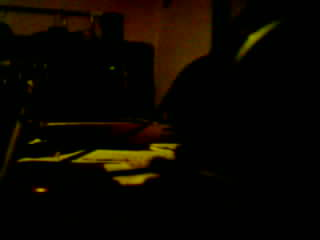
Code/ZZ_extras/example pictures from Arducam/10.JPG
