NikitaSardesai/AERO3760-Space-Engineering-2/failre.png

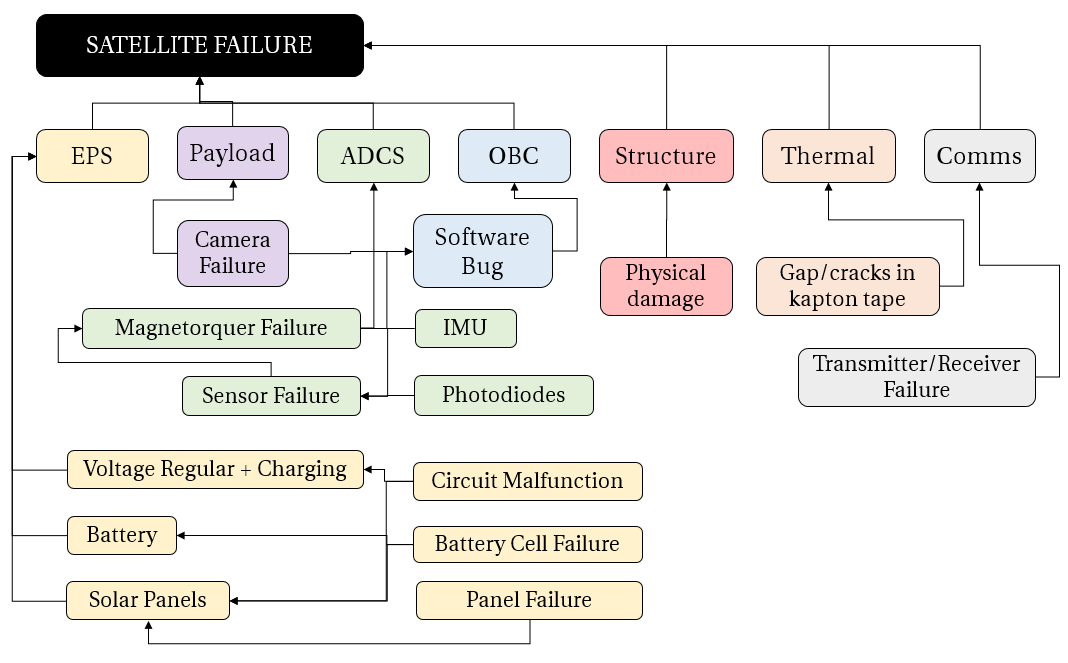
failre.png
