NikitaSardesai/AERO3760-Space-Engineering-2/PCBlayout/preview.PNG

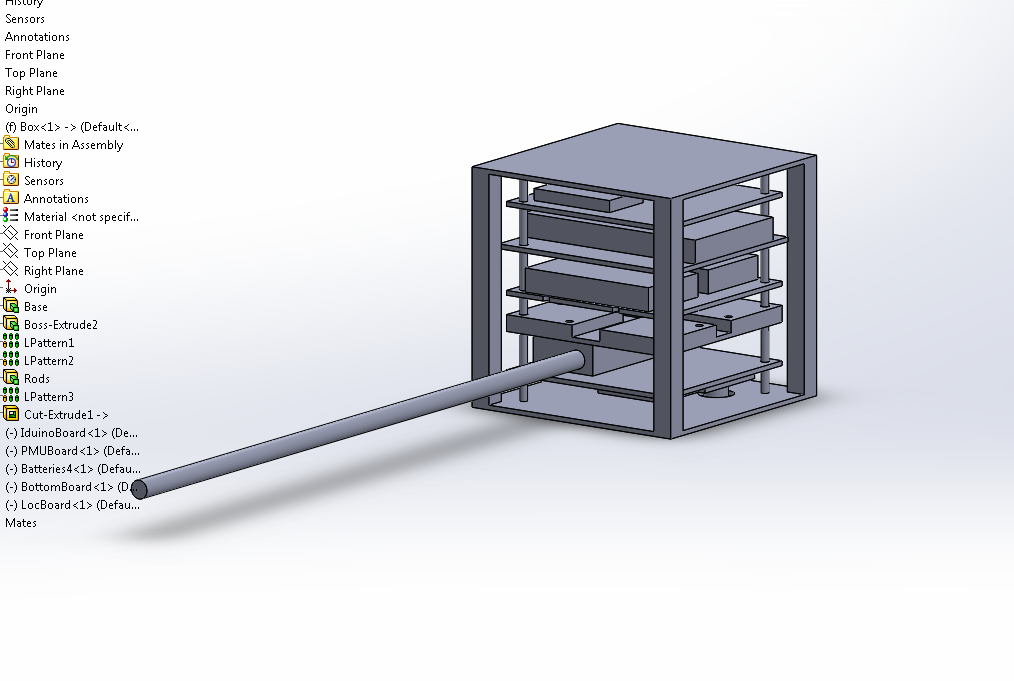
PCBlayout/preview.PNG
