NikitaSardesai/AERO3760-Space-Engineering-2/PDR TeX/DesignSchematicExample.png

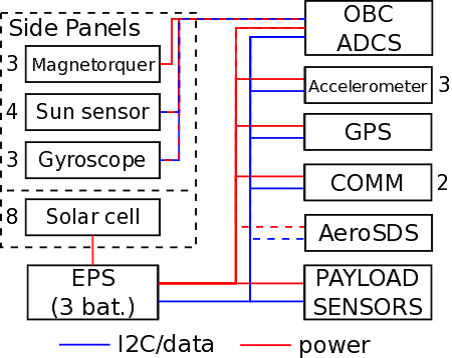
PDR TeX/DesignSchematicExample.png
