NikitaSardesai/AERO3760-Space-Engineering-2/PDR TeX/flow1.jpg

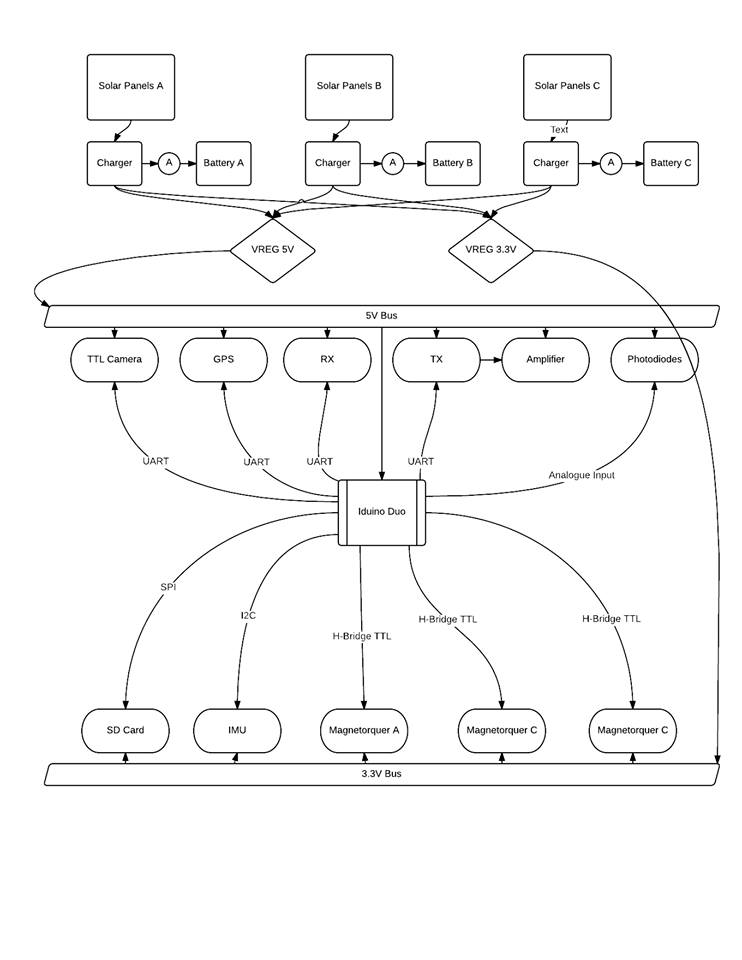
PDR TeX/flow1.jpg
