NikitaSardesai/AERO3760-Space-Engineering-2/PDR TeX/flow2.jpg

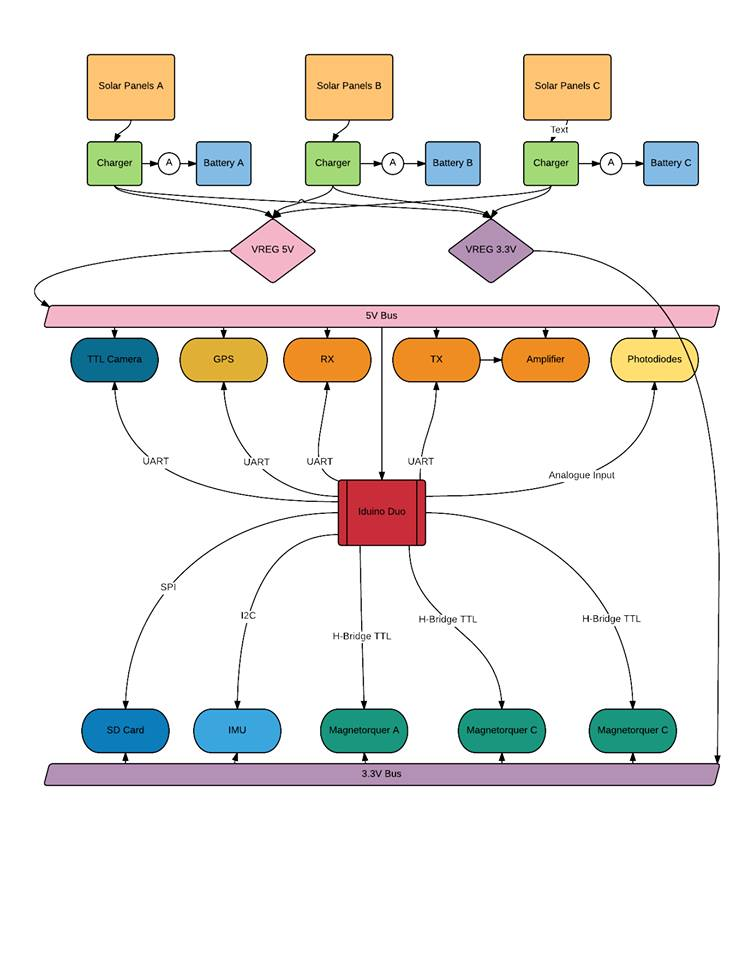
PDR TeX/flow2.jpg
