NikitaSardesai/AERO3760-Space-Engineering-2/PDR TeX/flower.PNG

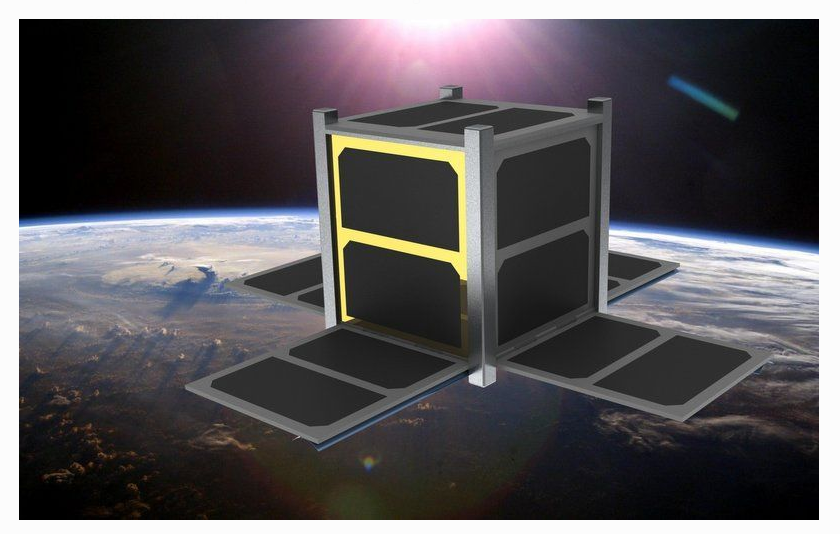
PDR TeX/flower.PNG
