NikitaSardesai/AERO3760-Space-Engineering-2/PDR TeX/snapsat.png

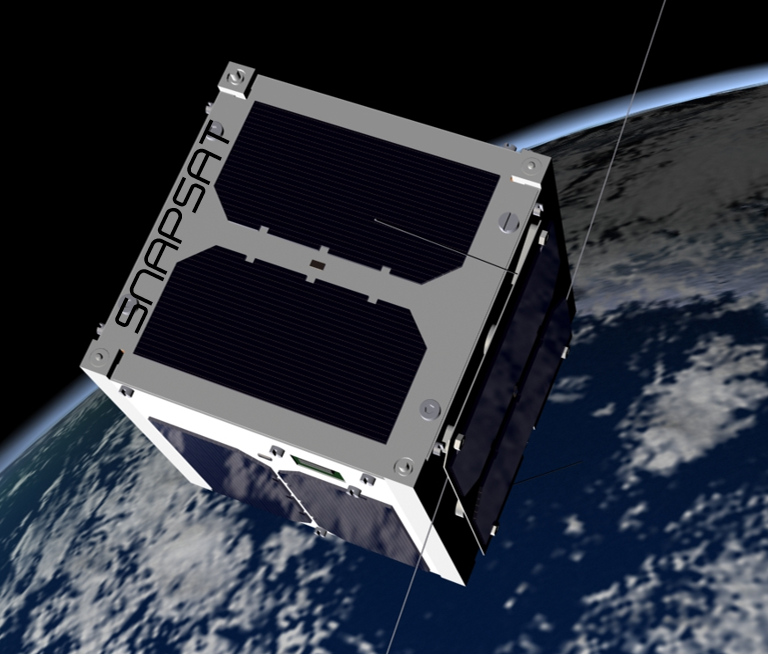
PDR TeX/snapsat.png
