NikitaSardesai/AERO3760-Space-Engineering-2/Picture1.png

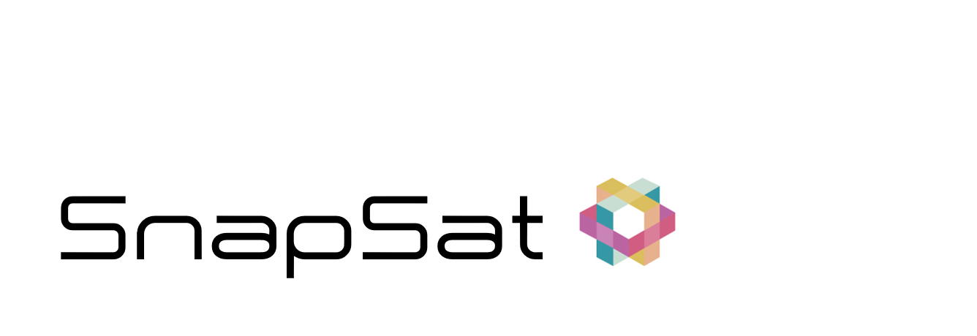
Picture1.png
