NikitaSardesai/AERO3760-Space-Engineering-2/Shopping List 1.xlsx

Shopping List
Item | Quantity | Cost | Q*C | Link | Operating Voltage | Operating Current | Interface | Num of Pins | Notes
Current Sensors | 4 | $6.56 | $26.24 | http://www.digikey.com.au/product-detail/en/ACS712ELCTR-20A-T/620-1190-1-ND/1284607 | 3.3 or 5 | 10mA | analogue input | 4 | to measure battery current, 3.3 V current, 5V current
Solar Panels | 1 | $116.65 | $116.65 | http://www.aliexpress.com/item/Wholesale-10pcs-lot-4-5Watt-6V-Monocrystalline-Silicon-Solar-Cells-High-Efficiency-Solar-Panel-DIY-Solar/32328601398.html | 6V |  | to EPS
 |  |  |  | http://www.dhgate.com/product/high-quality-6v-4-5w-mini-monocrystalline/246034033.html
Battery | 3 | $14.95 | $44.85 | http://www.adafruit.com/product/328 | 3.7V |  | N/A
 |  |  | $0.00
Charger | 3 | $17.50 | $52.50 | http://www.adafruit.com/products/390 |  |  | N/A
 |  |  | $0.00
Voltage regulators | 2 | $4.40 | $8.80 | http://www.ti.com/product/tps63020 |  |  | digi I/O
 |  |  | $0.00
Iduino Due (incl USB serial connector) | 1 | $53.89 | $53.89 | http://www.aliexpress.com/store/product/Iduino-Due-Pro-with-USB-Serial-Adapter-Completely-Compatible-For-Arduino-Due/902484_1480522596.html |  |  | all
 |  |  | $0.00
Photodiodes | 6 | $5.21 | $31.26 | OSRAM SFH203P PHOTODIODE | 5V | 4mA | analogue input | 6
 |  |  | $0.00
Arducam mini | 1 | $30.00 | $30.00 | http://www.ebay.com/itm/Arducam-Mini-module-Camera-Shield-w-2-MP-OV2640-for-Arduino-UNO-Mega2560-board-/281639729684 | 5V |  | SPI and I2C | 8 | could use parallel to serial interface, done in Tron 3
 |  |  | $0.00
SD card | 1 | $14.95 | $14.95 | https://www.adafruit.com/products/254 | 3.3V |  | SPI
 |  |  | $0.00 |  |  |  |  |  | need to do fram buffering, probably hard
IMU | 1 | $29.95 | $29.95 | http://www.adafruit.com/product/1604 |  |  | I2C |  | will need to replicate arduino shield if we don’t buy it
 |  |  | $0.00 |  |  |  |  |  | unsure if possible
Motor Controllers (H-bridge) | 2 | $2.35 | $4.70 | https://www.sparkfun.com/products/315 | 3.3V | 25mA | Digi I/O |  | are you sure 25mA will be enough??
 |  |  | $0.00
GPS | 1 | $39.95 | $39.95 | http://www.adafruit.com/products/746 | 3.3V | 20mA | UART
 |  |  | $0.00
Comms Tx | 1 |  | $0.00 |  |  |  | UART
 |  |  | $0.00
Comms Rx | 1 |  | $0.00 |  |  |  | UART
 |  |  | $0.00
Amplifier Tx |  |  | $0.00
 |  |  | $0.00
Insulating material |  |  | $0.00 |  |  |  | N/A
 |  |  | $0.00
PCBs | 4 | $40.00 | $160.00 | approximately |  |  | N/A
 |  |  | $0.00
Logic shifter | 1 | 1.11 | $1.11 | http://au.element14.com/texas-instruments/cd4504bm/logic-hex-volt-lvl-shifter-16soic/dp/1740091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|pcrid|59148083448&CMP=KNC-GOO-SHOPPING-1740091&CAGPSPN=pla&gclid=Cj0KEQjw6vquBRCow62uo-_J_YYBEiQAMO6HithHJH2KeFxDmIA9WUQgCRz4TNgxjyHaxKEtdK-PfZ8aAil_8P8HAQ&CAWELAID=120185580000383207&gross_price=true | 5 to 3.3V | 6.8mA
 |  |  | $0.00
FRAM | 1 | 5.95 | $5.95 | http://www.adafruit.com/products/1897 | 3.3V |  |  |  | unknown if we need this
 |  |  | $0.00
Kapton Tape | 1 | $18.50 | $18.50 | http://www.altronics.com.au/p/t2975-24mm-x-33m-high-temperature-polyimide-tape/
 |  |  | $0.00 | http://www.mektronics.com.au/production-aids/kapton-tape-discs-arrows-wave-solder-tape/economy-polymide-heat-proof-tape-25mm-33m.html
 |  |  | $0.00
MOSFETS | 10 | 0.67 | $6.70 | http://www.digikey.com.au/product-detail/en/DMP2035U-7/DMP2035U-7DICT-ND/2181234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
Total |  |  | $646.00
