NikitaSardesai/AERO3760-Space-Engineering-2/Annex 1 SnapSat_Overview_Spreadsheet.xlsx

Sheet: CubeSat Design Summary
[CubeSat Name] Design Overview Spreadsheet |  |  |  |  |  |  |  |  |  |  |  |  |  |  | In-House Devleopment
 |  |  |  |  |  |  |  |  |  |  |  |  |  |  | Procurement
 |  |  |  |  |  |  |  |  |  |  |  |  |  |  | Redundant in-house and procured system
Note: Please answer the following questions underneath each cell. And please do not modify the template. |  |  |  |  |  |  |  |  |  |  |  |  |  |  | Yes | No (see Request for Waiver)
 |  |  |  |  |  |  |  |  |  |  |  |  |  | Yes (see design document) | No
 |  |  |  |  |  |  |  |  |  |  |  |  |  |  | N/A
CubeSat Info
Reference number | CubeSat name | Lead institute | Country |  |  |  |  |  |  |  |  |  |  |  | 2U
 |  |  |  |  |  |  |  |  |  |  |  |  |  |  | 3U
Structural Subsystem |  |  |  |  |  |  |  |  |  |  |  |  |  |  | INMS
In-House Development / Procurement | Company / Organization | Total mass with contingency (grams) | Size (2U / 3U) | Sensor Payload (INMS, FIPEX, mNLP or N/A) | Other Payload |  |  |  |  |  |  |  |  |  | FIPEX
 |  |  |  |  |  |  |  |  |  |  |  |  |  |  | mNLP
 |  |  |  |  |  |  |  |  |  |  |  |  |  |  | N/A
Attitude Determination and Control Subsystem
In-House Development / Procurement | Company / Organization | ADCS offered by Surrey Space Centre (UK)* | Attitude change required by payload or mission scenario | Specify any special requirements on deployment of the CubeSat (if applicable) | Deployables |  |  | On board propulsion
 |  |  |  |  | Deployable structures (excluding antennas and MNLP) | The increase in drag area (%) | Time of deployment (i.e Day 1, 1 week after commission, etc) | Delta V (m/s) | Isp (s) | Force (mN) | Start of Thrust (i.e Day 1, 1 week after commission, 1 month after deployment, etc)
Electrical Power Subsystem
In-House Development / Procurement | Company / Organization | Overall efficiency of the EPS (%) | Number of solar cells | Battery capacity (Wh)
On-board Computer and On-board Data Handling Subsystem
In-House Development / Procurement | Company / Organization
Communication Subsystem
In-House Development / Procurement | Company / Organization | AX.25 | Protocol (if not AX.25) | Uplink |  |  | Downlink
 |  |  |  | Modulation | Frequency (MHz) | Data Rate (bps) | Modulation | Frequency (MHz) | Data Rate (bps) | S/C transmit power (mW)
Ground Segment
Satellite Control Software offered by EPFL** | Ground Station |  |  |  |  |  |  |  | Mini-Network
 | Location - Latitude (deg) | Location - Longitude (deg) | Minimum elevation mask (deg) | Supports UHF | Supports VHF | Supports S-band | Supports other bands (please specify) | Supports modulations (please specify) | Plan to use mini-ground station network*** | Have identified mini-network partners | Mini-network partner #1 | Mini-network partner #2 | Mini-network partner #3
Thermal Control Subsystem
In-House Development / Procurement | Company / Organization | Passive / Active
Legal Aspects
Agree to have space object registration of the CubeSat through VKI in Belgium | Agree to have frequency allocation through VKI in Belgium?
* The ADCS from SSC is customized for the QB50 project. It is able to meet the QB50 attitude requirements but there are certain limitations.
** The Satellite control Software (SCS) is a ground segment architecture provided by EPFL free of charge for the teams wishing to use it.
*** Mini ground station network is considered to be a network of about 3 to 5 ground stations. The SCS from EPFL has the capability to form a ground station network. Therefore, teams that choose to use the SCS from EPFL are encouraged to collaborate with each other to form a network of 3 to 5 ground stations that is geographically well distributed.

Sheet: Bill of Materials
Group E: SnapSat Bill of Materials
Note: - Please indicate if there are any ITAR components. If so, please indicate the process which is being used to ensure that it will not be problematic. - The level of detail in the BoM should be to the degree it can be disassembled. For non-structural components, the material of the board is sufficient (it is not necessary to include the components on the board). - Please specify in the comments column if any material is highly degradable or requires special handing instructions (i.e pressurized vessels, propellants).
Component | Material | Shelf Life (in ambient conditions, if applicable) | Quantity | Comments (specify if highly degradrable or requires special handling instructions) | Total Price ($) | ITAR export restricted (Yes, No) | Export license for launch in Brazil obtained (Yes, No) | Date
Structural Subsystem
Structure | 0.8mm Alumium 6061 |  | 1
3D Printed (organised with USyd 3D printing Lab) |  |  | 1
Attitude Determination and Control Subsystem
Inertial Measurement Unit |  |  | 1 | http://www.adafruit.com/product/1604 | 29.95
OSRAM SFH203P Photodiode | Silicon Pin |  | 6 |  | 31.26
Adafruit Ultimate GPS Breakout |  |  | 1 |  | 39.95
Air Core Magnetorquer (n = 312 turns, A = 0.0064m^2) | Copper Wire 0.18mm |  | 3 | Self Manufacture | 0.00
Electrical Power Subsystem
Battery |  |  | 4 | http://www.adafruit.com/product/328
Adafruit USB/DC Charger | Lithium Ion/Polymer |  | 4 | http://www.adafruit.com/products/390 | 52.50
Voltage Regulators - MC33063A - 1.5-A Peak Boost/Buck/Inverting Switching Regulator |  |  | 2 | http://www.ti.com/product/MC33063A/description | 8.80
Current Sensors |  |  | 4 | http://www.digikey.com.au/product-detail/en/ACS712ELCTR-20A-T/620-1190-1-ND/1284607 | 26.24
Solar Panels |  |  | 1 x 9 | http://www.aliexpress.com/item/Wholesale-10pcs-lot-4-5Watt-6V-Monocrystalline-Silicon-Solar-Cells-High-Efficiency-Solar-Panel-DIY-Solar/32328601398.html | 116.65
On-board Computer and On-board Data Handling Subsystem
Iduino Due (Include USB serial connector) |  |  | 1 |  | 53.89
Adafruit SPI Non-Volatile FRAM Breakout |  |  | 1 |  | 5.95
PCBs |  |  | 4 |  | 160.00
Communication Subsystem
Comms Tx & Rx |  |  | 1 | http://store.rfdesign.com.au/rfd-900p-modem/
Rubber Duck Antennae |  |  | 1 | http://www.l-com.com/wireless-antenna-900-mhz-5dbi-rubber-duck-antenna-rp-sma-plug-connector#
GPS: Assembled uBLOX MAX-M8C Pico Breakout with Chip Antenna |  |  | 1 | http://ava.upuaut.net/store/index.php?route=product/product&path=59_60&product_id=52
Thermal Subsystem
Kapton Tape | Polymide | 12 Months | 3 |  | 18.50
Multi-Layer Insulating Material |  |  | 1
Payload
Arducam Mini |  |  | 1 | http://www.ebay.com/itm/Arducam-Mini-module-Camera-Shield-w-2-MP-OV2640-for-Arduino-UNO-Mega2560-board-/281639729684 | 30.00
SD Card |  |  | 1 | https://www.adafruit.com/products/254 | 14.95
 |  |  |  | Overall Price | 588.64

Sheet: Mass Budget
SnapSat Mass Budget
Note: Please indicate how the contingency was calculated for each component. (I.e a component that is still under development should have a greater contingency than one that has already been manufactured).
Component | Development Status | Per Unit Mass (grams) |  |  | [CubeSat Name] Mass (grams) |  |  | Comments
 |  | Estimated Mass | Contingency | Total | Quantity | Contingency | Mass
Structural Subsystem
Chassis | Built | 150 | 30 | 180 | 2 | 60 | 360
Attitude Determination and Control Subsystem
Magnetorquers |  | 30 | 3 | 33 | 3 | 9 | 99
Sun Sensors
IMU
Electrical Power Subsystem
Batteries |  | 60 | 0 | 60 | 1 | 0 | 60
Power Bus
On-board Computer and On-board Data Handling Subsystem
Iduino DUE Board
Printed Circuit Boards
Memory Storage (SD Card and Reader)
Communication Subsystem
Antennae
Transcievers
Thermal Subsystem
Kapton Tape |  | 5
Payload
Arducam
Subtotal
Integration
Total
Target
Margin

Sheet: Power Budget
SnapSat Power Budget
Note: Please indicate all the assumptions that were used in calculating the power budget. Please note that the worst case attitude should be considered for the power generation in the modes that have no attitude control (i.e Safe mode).
 |  |  | Assumptions
Altitude (km) |  |  | 380
Albedo (%) |  |  | 35
Attitude |  |  | Inertial sun stare of the smallest face
Orbit (minutes) |  |  | 95
Power per solar cell (W) |  |  | 1.6
Any other assumptions
 |  |  | Average Duty Cycle by Mode (%)
Loads | Power Consumption (W) | Number of Units ON | Safe mode | Recovery mode
OBC | 0.450 | 1 | 100 | 100
VHF Rx | 0.250 | 1 | 100 | 100
S-band Tx | 2 | 1 | 1 | 3
Sum loads (W)
Efficiency
Power Consumed (W)
Power Generated (W)
Power Margin (%)

Sheet: Link Budget (Uplink)
SnapSat Link Budget (Uplink)
Note: Please use the spreadsheet from the provided website to calculate the uplink budget. (http://www.amsatuk.me.uk/iaru/spreadsheet.htm)
Use the AMSAT-IARU_Basic Analog Transponder Link_Budget_Rev1.6.xlsx Excel file
The AMSAT/IARU link budget spreadsheets performs a basic analysis for the uplink and downlink by comparing the gains and loses in the space link and providing a first estimation of the signal/noise ratio.
Fill out the sheets 1 to 5 by checking and updating all necessary input values. Input values are marked either with blue background and font color (critical values) or with blue font over white background (less important values). All other values are given or will be computed and therefore do not need to be changed.
After finishing the link budget analysis, copy the complete results from the summary sheets for uplink (sheet 6) to this sheet.
Information on the System
Transmitter - Ground Station | Receiver - SnapSat
Orbit Altitude – 350km | Elevation – 30 degrees
Slant Range – 652.5km | Weather – Clear Sky
Demodulation Method – AFSK | Cable Length – 20m
Antenna Type (TX) – Cross Yagi | Antenna Type – Dipole or 2 quarter length monopole
Transmitter System (Ground Station)
Ground Station Transmitter Power Output |  | 100 W
 |  | 20 dBW
Ground Station Total Transmission Line Losses |  | 3.4dB
Ground Station Antenna Gain |  | 18.9dBi
Ground Station ERIP |  | 35.5dBW
Down Link Path
Free-Space Path Loss |  | 132 DB
Satellite Antenna Pointing Loss (10 °) |  | 10.6 dB
Ground Station Antenna Pointing Loss (10°) |  | 2.7 dB
Satellite Transmission Line Losses |  | 0.5 dB
Atmospheric Loss (30°) |  | 0.4 dB
Ionspheric Loss |  | 0.4 dB
Rain Loss |  | 0
Total Loss |  | 146.6dB
Receiver System (on SnapSat)
Antenna Gain |  | 2.7 dBi
Effective Noise Temperature at Space (350K/Day) |  | 1345K
Figure of Merrit (G/Ta) |  | -28.6 dB/K
Carrier-to-Thermal-Noise Ratio (C/T) |  | -136.6 dB
Boltzmann’s constant (K) |  | -228.6 dBW/K/Hz
Carrier-to-Noise Density Ratio C/No |  | 88.9 dBHz
Modulation Process
System Desired Data Rate |  | 1200 bps
Demodulation Method Selected |  | AFSK
System Allowed or Specified Bit-Error-Rate |  | 0.0001
Demodulator Implementation Loss |  | 2 dB
Link Performance
Required Eb/No |  | 56.1 dB
Threshold Eb/No |  | 23.2 dB
System Link Margin |  | 32.9 dB

Sheet: Link Budget (Downlink)
SnapSat Link Budget (Downlink)
Note: Please use the spreadsheet from the provided website to calculate the downlink budget. (http://www.amsatuk.me.uk/iaru/spreadsheet.htm)
Use the AMSAT-IARU_Basic Analog Transponder Link_Budget_Rev1.6.xlsx Excel file
The AMSAT/IARU link budget spreadsheets performs a basic analysis for the uplink and downlink by comparing the gains and loses in the space link and providing a first estimation of the signal/noise ratio.
Fill out the sheets 1 to 5 by checking and updating all necessary input values. Input values are marked either with blue background and font color (critical values) or with blue font over white background (less important values). All other values are given or will be computed and therefore do not need to be changed.
After finishing the link budget analysis, copy the complete results from the summary sheets for downlink budget (sheet 7) to this sheet.
Information on the System
Transmitter - SnapSat | Receiver - Ground Station
Orbit Altitude – 350km | Elevation – 30 degrees
Slant Range – 652.5km | Weather – Clear Sky
Demodulation Method – AFSK | Cable Length – 20m
Antenna Type (TX) – Quarter length | Antenna Type – Cross Yagi
Transmitter System (SnapSat)
Satellite Transmitter Power Output |  | 0.5W
 |  | -3.01 dBW
Satellite Total Transmission Line Losses |  | 0.5 dB
Satellite Antenna Gain |  | 2.7 dBi
Satellite ERIP |  | -0.81 dBW
Down Link Path
Free-Space Path Loss |  | 132 DB
Satellite Antenna Pointing Loss (10 °) |  | 10.6 dB
Ground Station Antenna Pointing Loss (10°) |  | 2.7 dB
Satellite Transmission Line Losses |  | 0.5 dB
Atmospheric Loss (30°) |  | 0.4 dB
Ionspheric Loss |  | 0.4 dB
Rain Loss |  | 0
Total Loss |  | 146.6dB
Receiver System (Ground Station)
Antenna Gain |  | 14.4 dBi
Effective Noise Temperature at Space (350K/Day) |  | 610.1K
Figure of Merrit (G/Ta) |  | 13.5 dB/K
Carrier-to-Thermal-Noise Ratio (C/T) |  | -160.71 dB
Boltzmann’s constant (K) |  | -228.6 dBW/K/Hz
Carrier-to-Noise Density Ratio C/No |  | 67.89 dBHz
Modulation Process
System Desired Data Rate |  | 9600 bps
Demodulation Method Selected |  | AFSK
System Allowed or Specified Bit-Error-Rate |  | 0.0001
Demodulator Implementation Loss |  | 2 dB
Link Performance
Required Eb/No |  | 26.07 dB
Threshold Eb/No |  | 10.5 dB
System Link Margin |  | 15.56 dB
