NikitaSardesai/AERO3760-Space-Engineering-2/Documents/Budgets.xlsx

Sheet: Sheet1
Budgeting
Cost | $1000
Weight | 1kg
Size | 100x100x100mm
Power | ~1W
Solar Panel Options | Link | Cost | V | I | Power
ClydeSpace solar panels |  | $2825.00
Australian Robotics | http://www.australianrobotics.com.au/products/1w-solar-panel-80x100 | $9.95 | 5.5V | 170mA | 935mW
RSonline | http://au.rs-online.com/web/p/photovoltaic-solar-panels/6646772/ | $8.57 | 4.9V
RSonline | http://au.rs-online.com/web/p/photovoltaic-solar-panels/6646807/ | $13.65 | 6V |  | 190mW
Solar Cell Small - 0.45W | https://www.sparkfun.com/products/7845 | $15.95 | 4.5V | 100mA
Microcontroller Options | Link | Cost | Power | Temp | Weight | Notes
Arduino | https://www.arduino.cc/ | $30 | 6V 20mA per io pin | -40 to 85 | tiny | Lots of libraries and forums
TI Low Power | http://www.ti.com/ww/en/launchpad/launchpads-msp430-msp-exp430fr5969.html#tabs | $15.99 | 1.8-3.6V | -40 to 85 | tiny | FRAM gives extra radiation resistance.
 | http://www.ti.com/product/MSP430FR5969/datasheet/specifications#SLAS704rod314 |  | 100muA active |  |  | Planetary resources using it.
 |  |  | 0.4muA standby |  |  | Lots of libraries and documentation, less forums
 |  |  |  |  |  | Similar specs
TL;DR: Arduino easier, TI better
Camera Options | Link | Cost | Power | Temp | Weight | Notes
Leopard, LI-CAM-AR0140HISPI | https://www.leopardimaging.com/uploads/LI-CAM-AR0140HISPI_datasheet.pdf | $190 | 2.4V, 22mA max, can turn off when not using
1Mp | https://www.leopardimaging.com/LI-CAM-AR0140HISPI.html |  |  | up to 150 | tiny | look hard to interface with
 |  |  |  |  |  | uses HiSPi
5Mp | https://www.leopardimaging.com/LI-CAM-OV5653-P33.html#1 | $169 | can't find good datasheet
arduino camera | http://www.dx.com/p/jtron-ov7670-300kp-vga-camera-module-for-arduino-works-with-official-arduino-boards-292824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 | $10 | similar to above |  |  | lower res
Resolution Calculator
camera FOV degrees (first one) | 54 | degrees
smallest feature | 0.3 | km
 | 100km | 30km
FOV | 90.79809995 | 27.23942998
resolution needed | 181.5961999 | 54.47885997
ADSC |  | Cost | Power | Temp | Weight | Notes
IMU Options
Adafruit 9-DOF | https://www.adafruit.com/products/1714 | $20 | Approx 30mW |  | 2.8g | Easy to Interface/Penny has used before
 |  |  |  |  |  | Not sure about radiation hardness
 |  |  |  |  |  | Don't think optional altimeter is worthwhile not accurate enough
 |  |  |  |  |  | Good beginner user manual with setup arduino code
Photodiodes | OSRAM SFH203P PHOTODIODE | $30 |  | -40 to 100 | 1.8g*6 (one on each face) | Will need either 5 or 6 which is reason for variation in price and weight.
 |  |  |  |  |  | On outside of satellite so worried about temperature
Magnetorquers
Air Core Magnetorquer | Copper Wire Round 0.18mm approx AWG 33 |  | 165mW | Size 8cm by 8cm | 66g total (22g each) | Unsure of exact weight requirements will depend of mass of satellite
 |  |  |  | Only if you can fit this
Motor Controllers (for magnetorquers)
buy extra, they might blow
GPS
adafruit
other
Comms downlink
Xbee
Battery
http://www.batteryspace.com/limnni-26650-rechargeable-cell-3-7v-4000-mah-4a-rated-14-8wh---ul-listed-un38-3-passed-ndgr.aspx
Comms uplink (for groundstation)
Antenna
Tape measure, plus heater to melt wires
SD card
Thermal control/insulation
Structure
3D printed, ABS plastic probably? it's within outbassing requirements, http://outgassing.nasa.gov/cgi/uncgi/search/search_ad.sh
Extra mass for connectors
PCBs
4 pcbs (power, microcontroller, comms, adsc)
connecting struts
CubeSat Spec Stuff/Extras
separation springs
RBF pin (buts power to satellite)

Sheet: Sheet2
Shopping List
Item | Quantity | Cost | Q*C | Link | Operating Voltage | Operating Current | Interface | Notes
Current Sensors | 4 | $6.56 | $26.24 | http://www.digikey.com.au/product-detail/en/ACS712ELCTR-20A-T/620-1190-1-ND/1284607 | 3.3 or 5 | 10mA | analogue input | to measure battery current, 3.3 V current, 5V current
 |  |  | $0.00
Solar Panels | 9 | $10 | $90.00 | http://www.eachbuyer.com/5v-200ma-1w-mini-solar-panel-module-diy-for-cell-charger-toy-p317320.html | 5V | 200mA | to EPS | may need more
 |  |  | $0.00
Battery | 1 | $20 | $20.00
 |  |  | $0.00
Arduino Due |  |  | $0.00
 |  |  | $0.00
Photodiodes |  |  | $0.00 | OSRAM SFH203P PHOTODIODE
 |  |  | $0.00
 |  |  | $0.00
 |  |  | $0.00
 |  |  | $0.00
 |  |  | $0.00
 |  |  | $0.00
 |  |  | $0.00
 |  |  | $0.00
 |  |  | $0.00
 |  |  | $0.00
 |  |  | $0.00
 |  |  | $0.00
 |  |  | $0.00
Total |  |  | $136.24
