NikitaSardesai/AERO3760-Space-Engineering-2/6061/Assem1.SLDASM

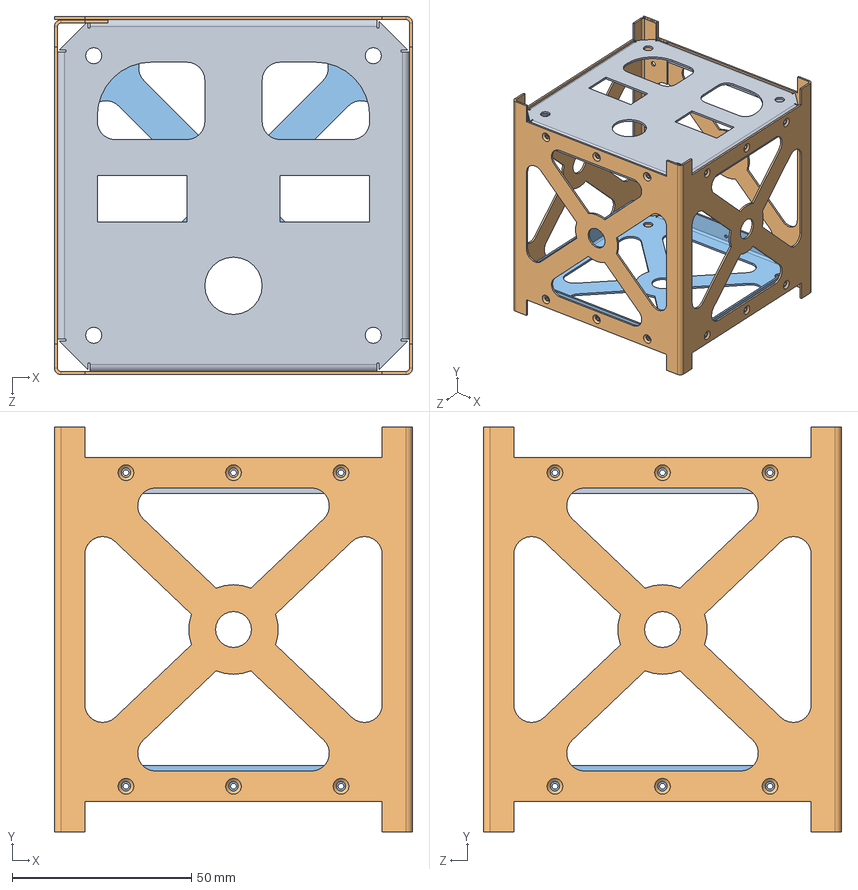
[picture p98: CAD file, 2015-08-22]
6061/Assem1.SLDASM
100.0 x 113.0 x 100.0 mm
connectors
walls
top
