NikitaSardesai/AERO3760-Space-Engineering-2/PCBlayout/Assembly.SLDASM

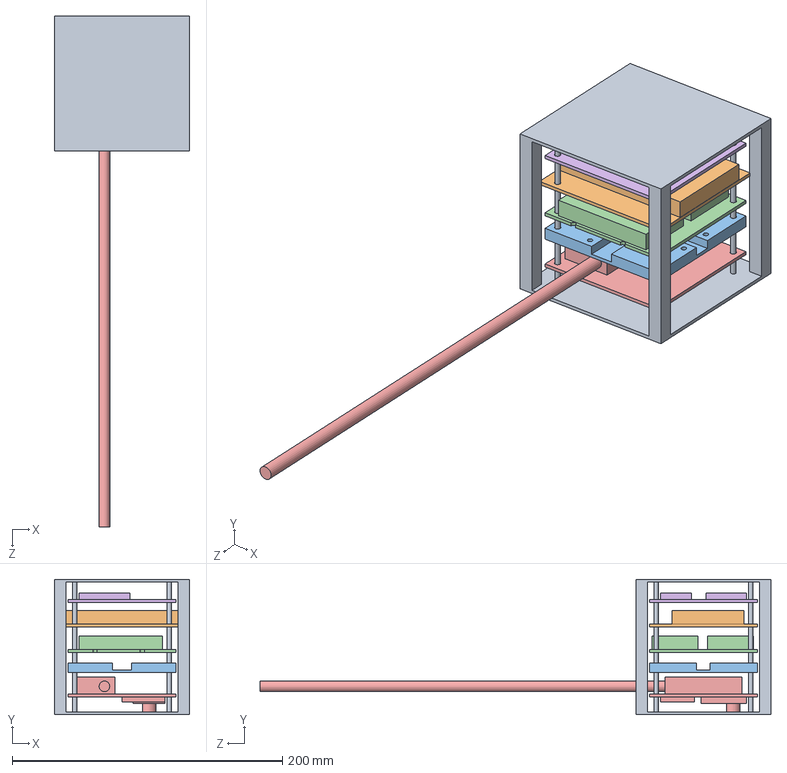
[picture p99: CAD file, 2015-09-15]
PCBlayout/Assembly.SLDASM
100.0 x 100.0 x 378.5 mm
IduinoBoard
PMUBoard
Batteries4
BottomBoard
LocBoard
