NikitaSardesai/AERO3760-Space-Engineering-2/6061/connectors.SLDPRT

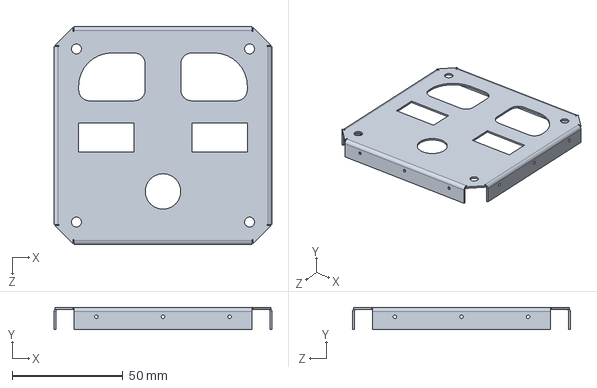
[picture p100: CAD file, 2015-08-22]
6061/connectors.SLDPRT
98.2 x 10.0 x 98.2 mm
