NikitaSardesai/AERO3760-Space-Engineering-2/PCBlayout/IduinoBoardAngle.SLDPRT

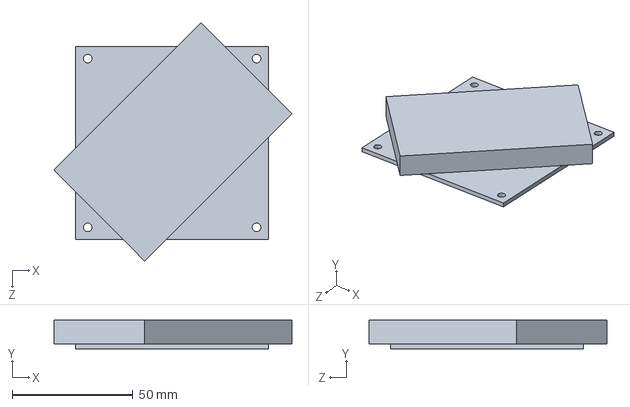
[picture p101: CAD file, 2015-09-15]
PCBlayout/IduinoBoardAngle.SLDPRT
98.7 x 12.0 x 98.8 mm
