NikitaSardesai/AERO3760-Space-Engineering-2/PCBlayout/Board.SLDPRT

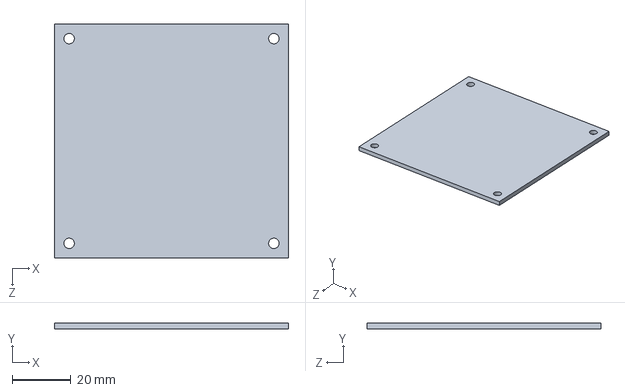
[picture p102: CAD file, 2015-09-15]
PCBlayout/Board.SLDPRT
80.0 x 2.00 x 80.0 mm
