NikitaSardesai/AERO3760-Space-Engineering-2/6061/top.SLDPRT

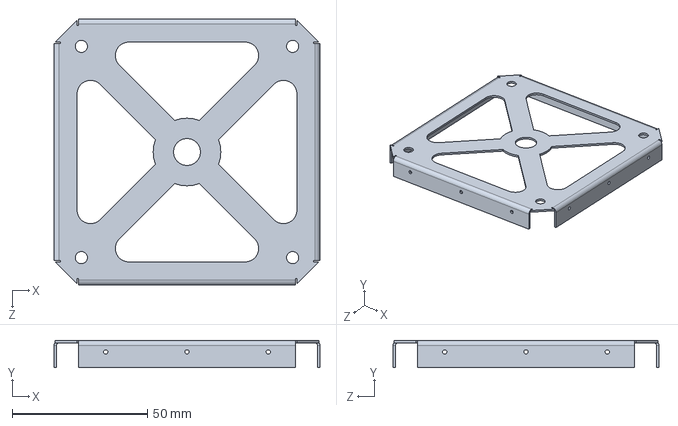
[picture p103: CAD file, 2015-08-22]
6061/top.SLDPRT
98.2 x 10.0 x 98.2 mm
