NikitaSardesai/AERO3760-Space-Engineering-2/PCBlayout/LocBoard.SLDPRT

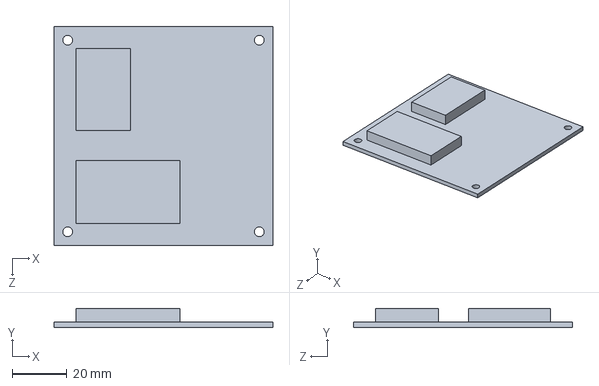
[picture p104: CAD file, 2015-09-15]
PCBlayout/LocBoard.SLDPRT
80.0 x 7.00 x 80.0 mm
