NikitaSardesai/AERO3760-Space-Engineering-2/PCBlayout/Batteries4.SLDPRT

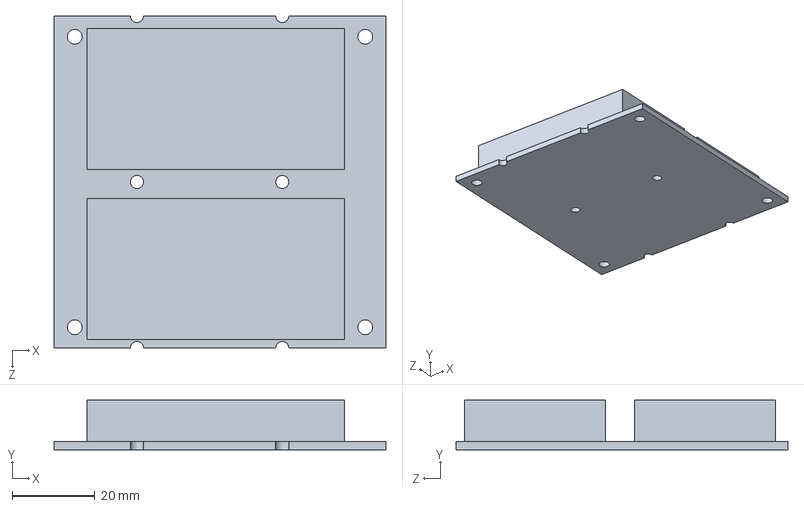
[picture p105: CAD file, 2015-09-15]
PCBlayout/Batteries4.SLDPRT
80.0 x 12.0 x 80.0 mm
