NikitaSardesai/AERO3760-Space-Engineering-2/PCBlayout/IduinoBoard.SLDPRT

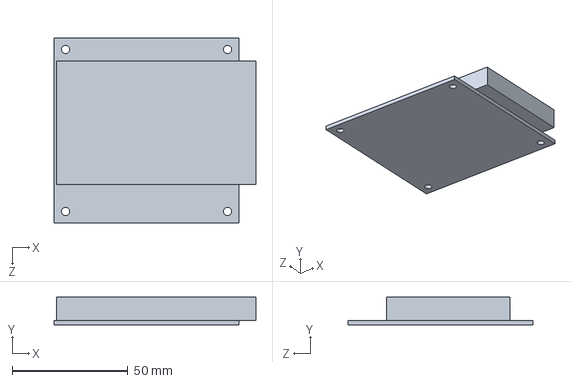
[picture p106: CAD file, 2015-09-15]
PCBlayout/IduinoBoard.SLDPRT
87.3 x 12.0 x 80.0 mm
