NikitaSardesai/AERO3760-Space-Engineering-2/PCBlayout/BottomBoard.SLDPRT

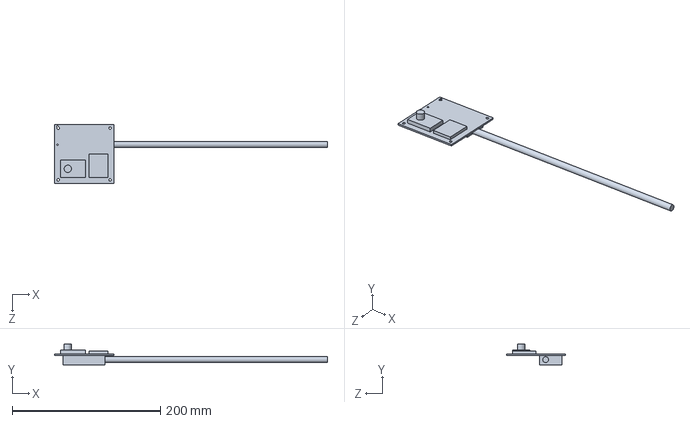
[picture p107: CAD file, 2015-09-15]
PCBlayout/BottomBoard.SLDPRT
368.5 x 27.8 x 80.0 mm
