NikitaSardesai/AERO3760-Space-Engineering-2/PCBlayout/PMUBoard.SLDPRT

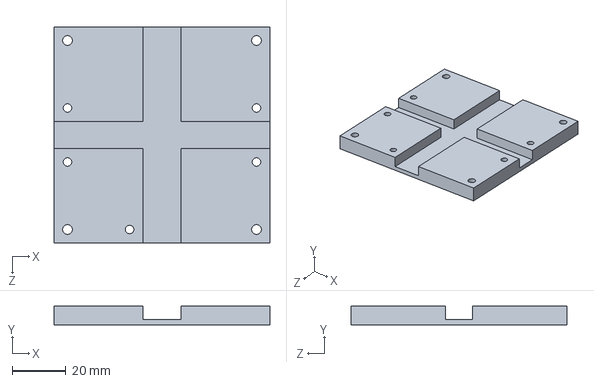
[picture p108: CAD file, 2015-09-15]
PCBlayout/PMUBoard.SLDPRT
80.0 x 7.00 x 80.0 mm
