NikitaSardesai/AERO3760-Space-Engineering-2/PCBlayout/Box.SLDPRT

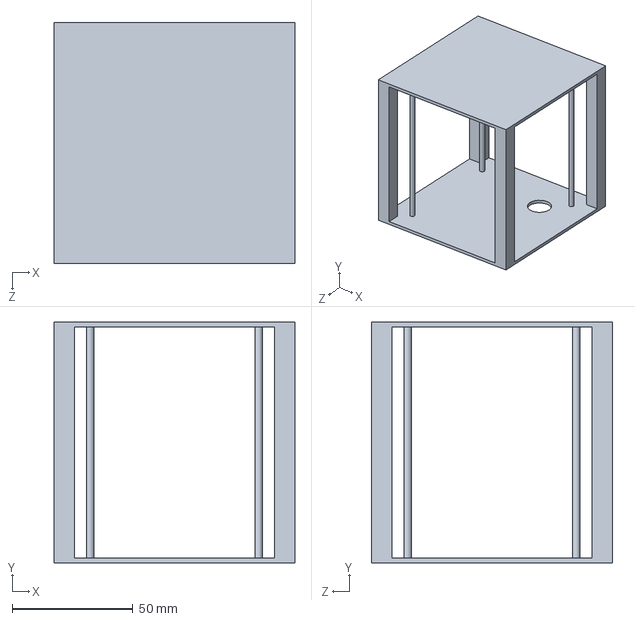
[picture p109: CAD file, 2015-09-15]
PCBlayout/Box.SLDPRT
100.0 x 100.0 x 100.0 mm
