NikitaSardesai/AERO3760-Space-Engineering-2/(list of files, cad)

Other CAD files:
6061/connectors.SLDDRW
6061/top.SLDDRW
6061/walls.SLDDRW
PCBlayout/Assembly.x_t
PCBlayout/Batteries4.x_t
PCBlayout/Board.x_t
PCBlayout/BottomBoard.x_t
PCBlayout/Box.x_t
PCBlayout/IduinoBoard.x_t
PCBlayout/IduinoBoardAngle.x_t
PCBlayout/LocBoard.x_t
PCBlayout/PMUBoard.x_t
