NikitaSardesai/AERO3760-Space-Engineering-2/PDR TeX/ModesOfOperation.png

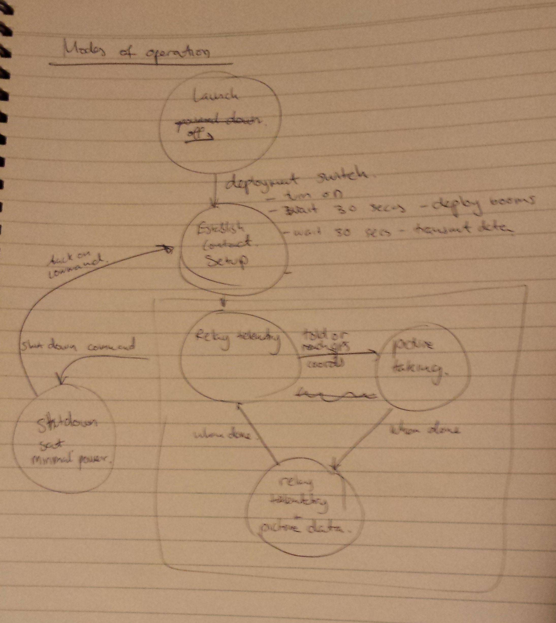
PDR TeX/ModesOfOperation.png
