NikitaSardesai/AERO3760-Space-Engineering-2/CDRTeX/figures/Circuit_Test_1.png

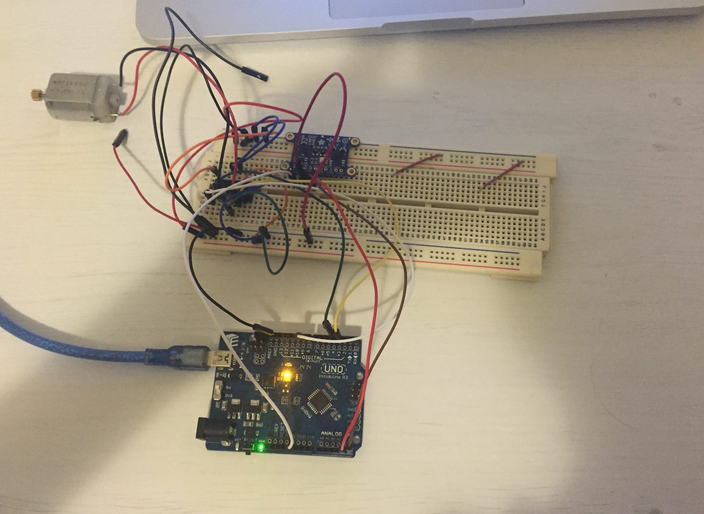
CDRTeX/figures/Circuit_Test_1.png
