NikitaSardesai/AERO3760-Space-Engineering-2/Eagle/Problems.txt

Problems

Fixed

bottomboard holes sized wrong
bottomboard camera wrong way around
MCU wrong way up
mcuboard pin headers wrong
all things need to be labelled
charging circuits wrong size
pmu board headers sized wrong

To Go

did voltage regulators actually get ordered?
