NikitaSardesai/AERO3760-Space-Engineering-2/6061/connectors.PDF

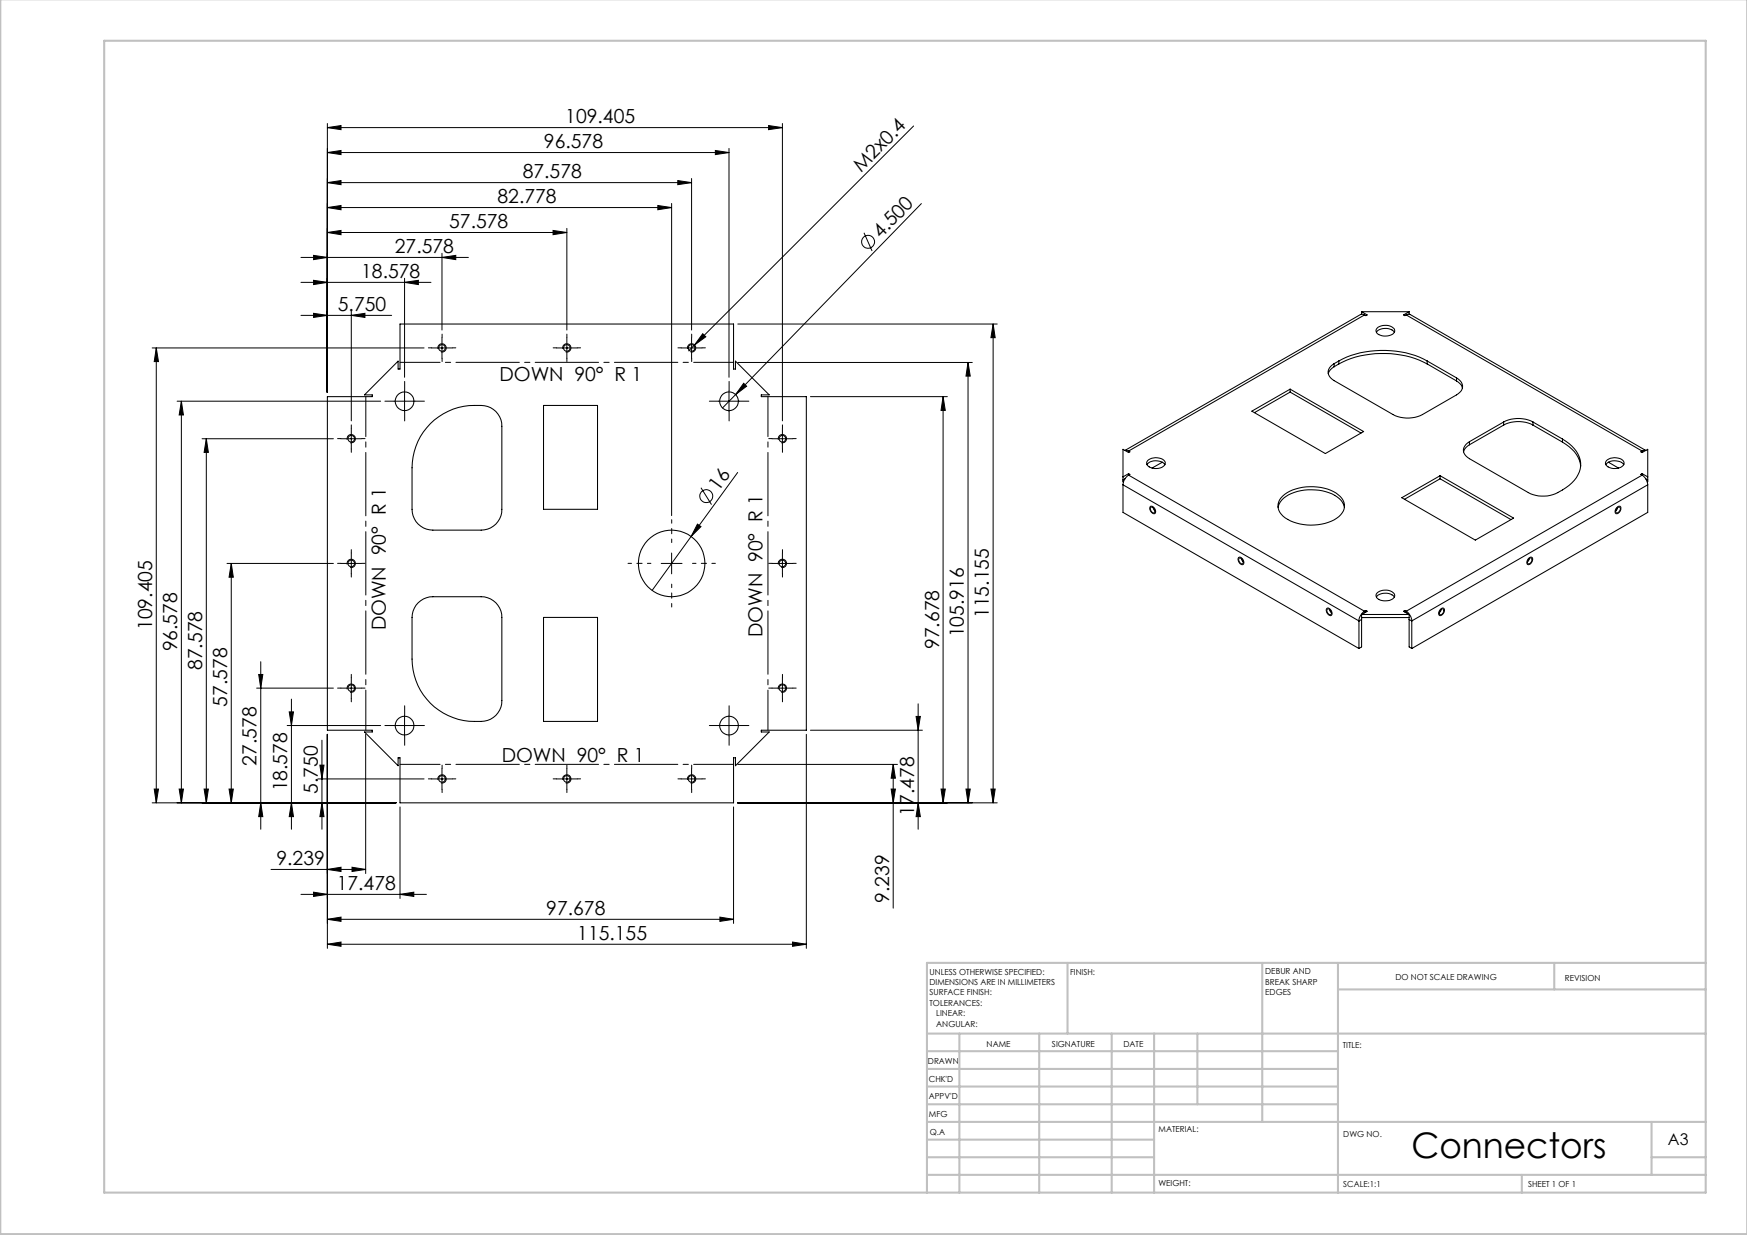
[picture p115: page 1]
DOWN 90° R 1; SCALE:1:1; SHEET 1 OF 1; DO NOT SCALE DRAWING; REVISION; DEBUR AND BREAK SHARP; UNLESS OTHERWISE SPECIFIED:; FINISH:

DIMENSIONS ARE IN MILLIMETERS
SURFACE FINISH:
TOLERANCES:
LINEAR:
ANGULAR:

NAME | SIGNATURE | DATE | | | | TITLE:
Q.A | | | | MATERIAL: | Connectors WEIGHT: DWG NO. | A3

DRAWN
CHK'D
APPV'D
MFG
