NikitaSardesai/AERO3760-Space-Engineering-2/6061/top.PDF

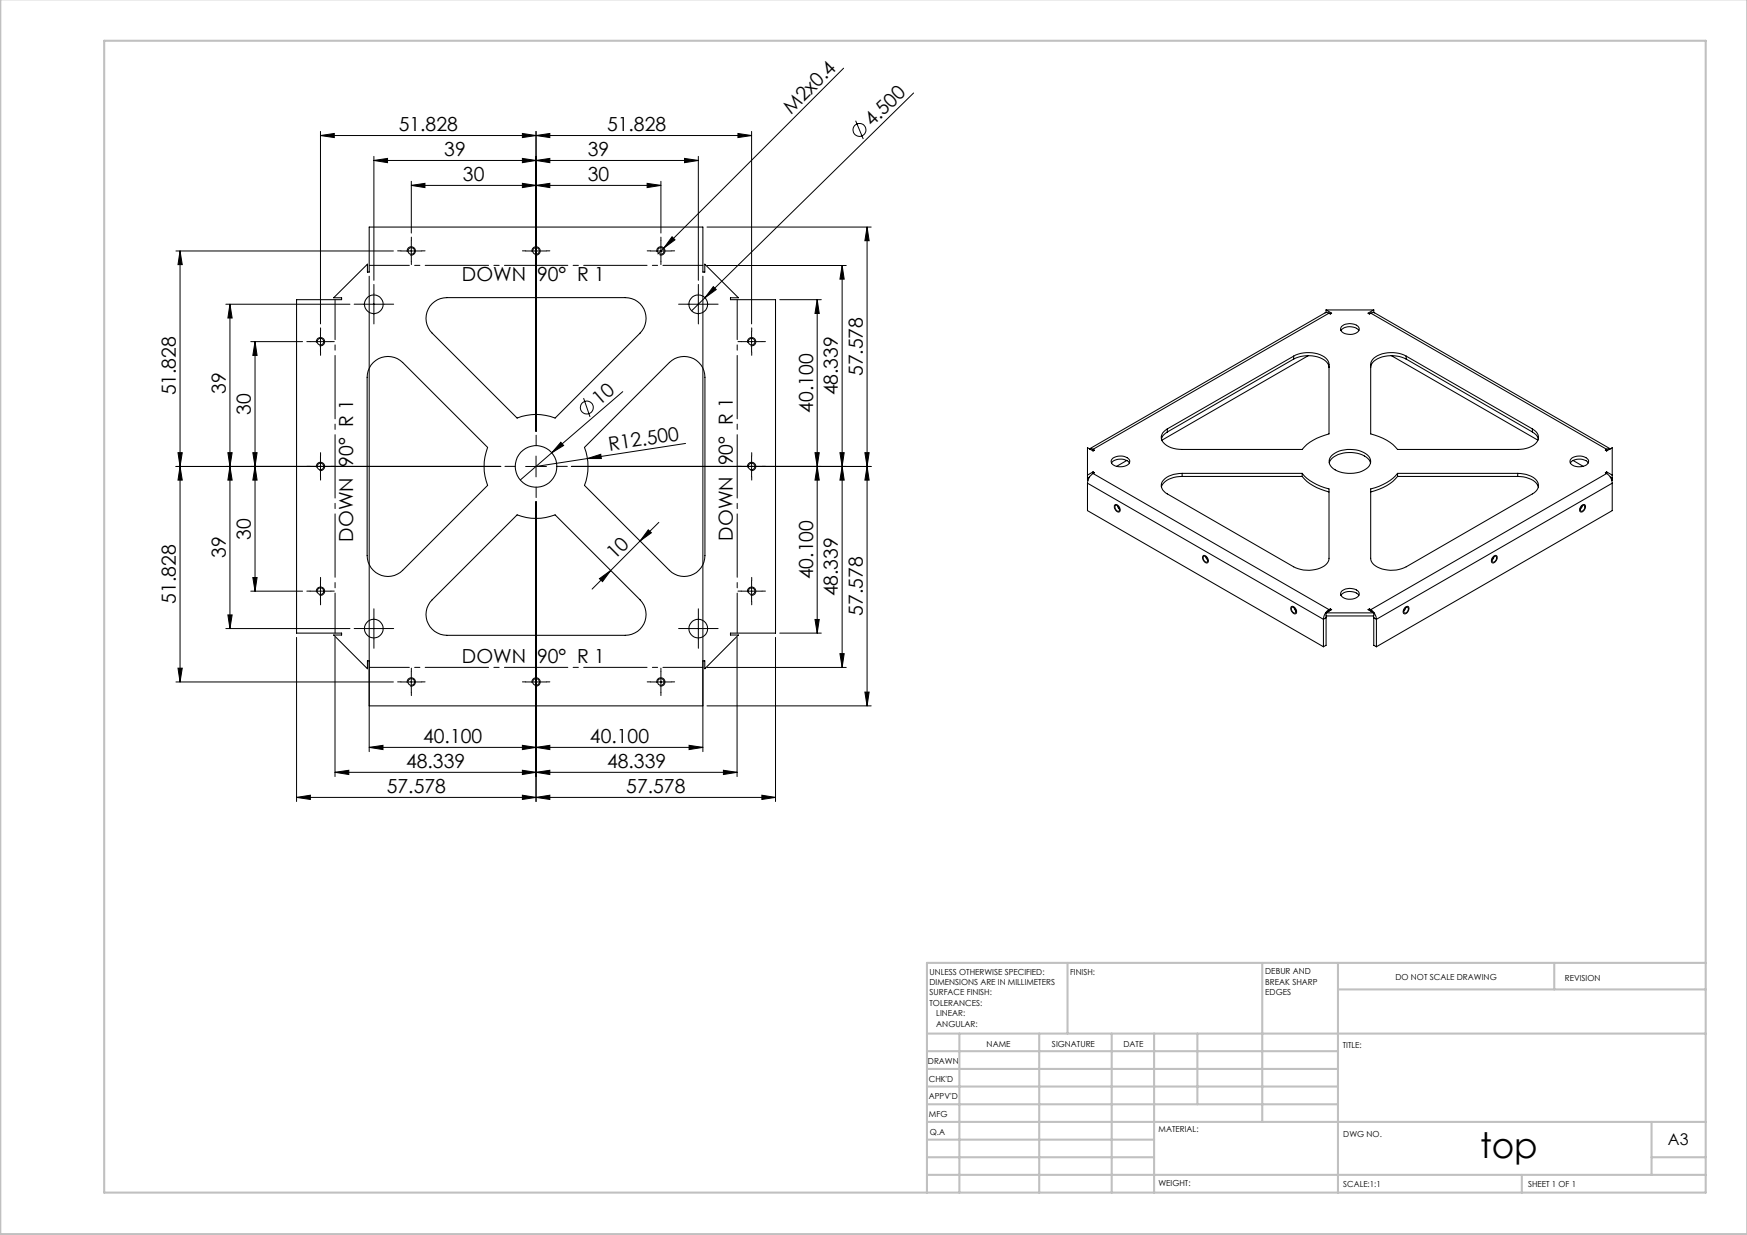
[picture p116: page 1]
DOWN 90° R 1; DOWN; SCALE:1:1; SHEET 1 OF 1; DO NOT SCALE DRAWING; REVISION; DEBUR AND BREAK SHARP; UNLESS OTHERWISE SPECIFIED:; FINISH:

39 | 39
30 | 30

DIMENSIONS ARE IN MILLIMETERS
SURFACE FINISH:
TOLERANCES:
LINEAR:
ANGULAR:

NAME | SIGNATURE | DATE | | | | TITLE:

DRAWN
CHK'D
APPV'D
MFG
Q.A | | | | MATERIAL: | top WEIGHT: DWG NO. | A3
