NikitaSardesai/AERO3760-Space-Engineering-2/Eagle/SnapSat/mcuboard.brd

## EAGLE design Eagle/SnapSat/mcuboard.brd (2015-10-19)

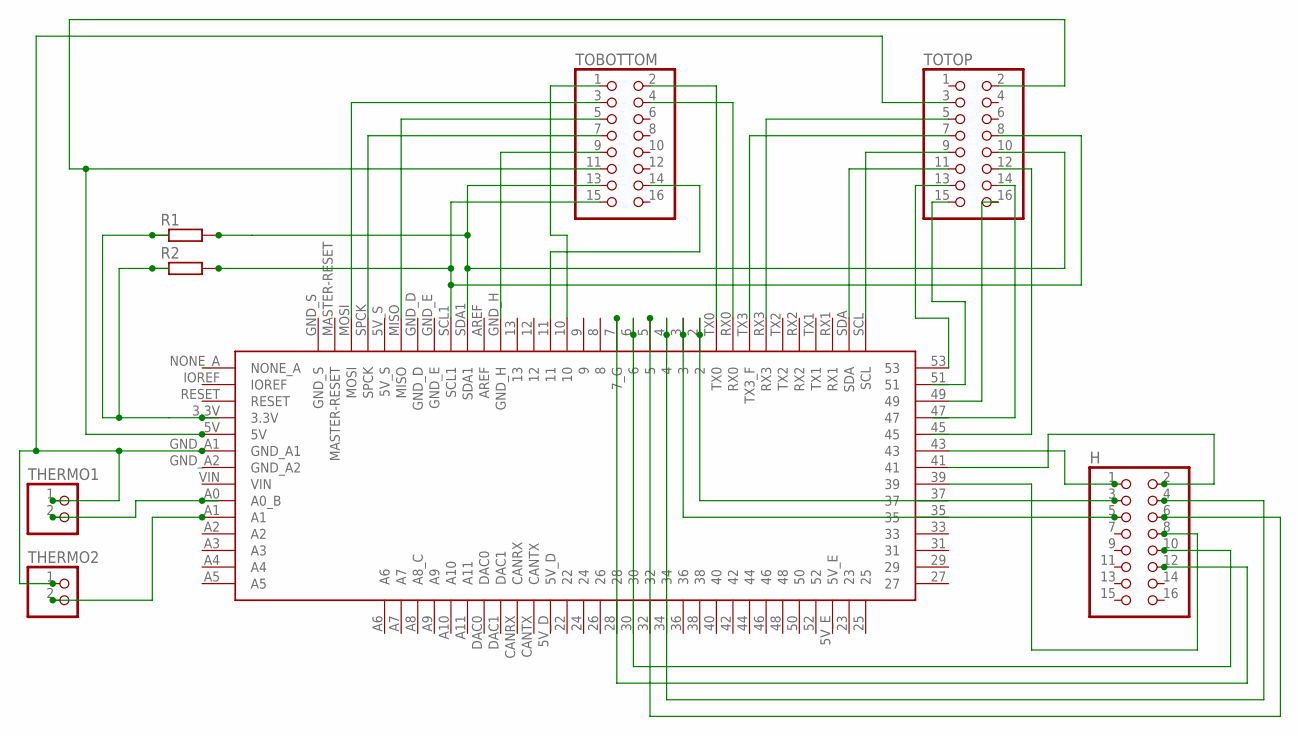
[picture p117: schematic mcuboard.sch]

Parts:
H: PINHD-2X8; 2X08
R1, R2: R-EU_0207_12; 0207/12
THERMO1, THERMO2: PINHD-1X2; 1X02
TOBOTTOM: PINHD-2X8; 2X08
TOTOP: PINHD-2X8; 2X08
U$1: IDUINO1; IDUINO_PAC

Connections:
unnamed: TOBOTTOM.7, U$1.SPCK
unnamed: TOBOTTOM.3, U$1.MOSI
unnamed: TOBOTTOM.5, U$1.MISO
unnamed: TOBOTTOM.9, U$1.GND_H
unnamed: TOBOTTOM.11, TOTOP.2, U$1.5V
unnamed: R1.2, TOBOTTOM.13, TOTOP.10, U$1.SDA1
unnamed: R2.2, TOBOTTOM.15, TOTOP.8, U$1.SCL1
unnamed: TOBOTTOM.2, U$1.TX0
unnamed: THERMO1.1, THERMO2.1, TOTOP.3, U$1.GND_A1
unnamed: TOBOTTOM.4, U$1.RX0
unnamed: TOBOTTOM.14, U$1.11
unnamed: TOBOTTOM.1, U$1.10
unnamed: TOTOP.5, U$1.RX3
unnamed: TOTOP.7, U$1.TX3 (TX3_F)
unnamed: TOTOP.9, U$1.SCL
unnamed: TOTOP.11, U$1.SDA
unnamed: R1.1, R2.1, U$1.3.3V
unnamed: TOTOP.13, U$1.53
unnamed: TOTOP.16, U$1.49
unnamed: H.1, U$1.43
unnamed: H.8, U$1.39
unnamed: H.3, U$1.2
unnamed: H.5, U$1.3
unnamed: H.4, U$1.4
unnamed: THERMO1.2, U$1.A0 (A0_B)
unnamed: H.2, U$1.41
unnamed: H.10, U$1.6
unnamed: H.12, U$1.7 (7_G)
unnamed: THERMO2.2, U$1.A1
unnamed: H.6, U$1.5

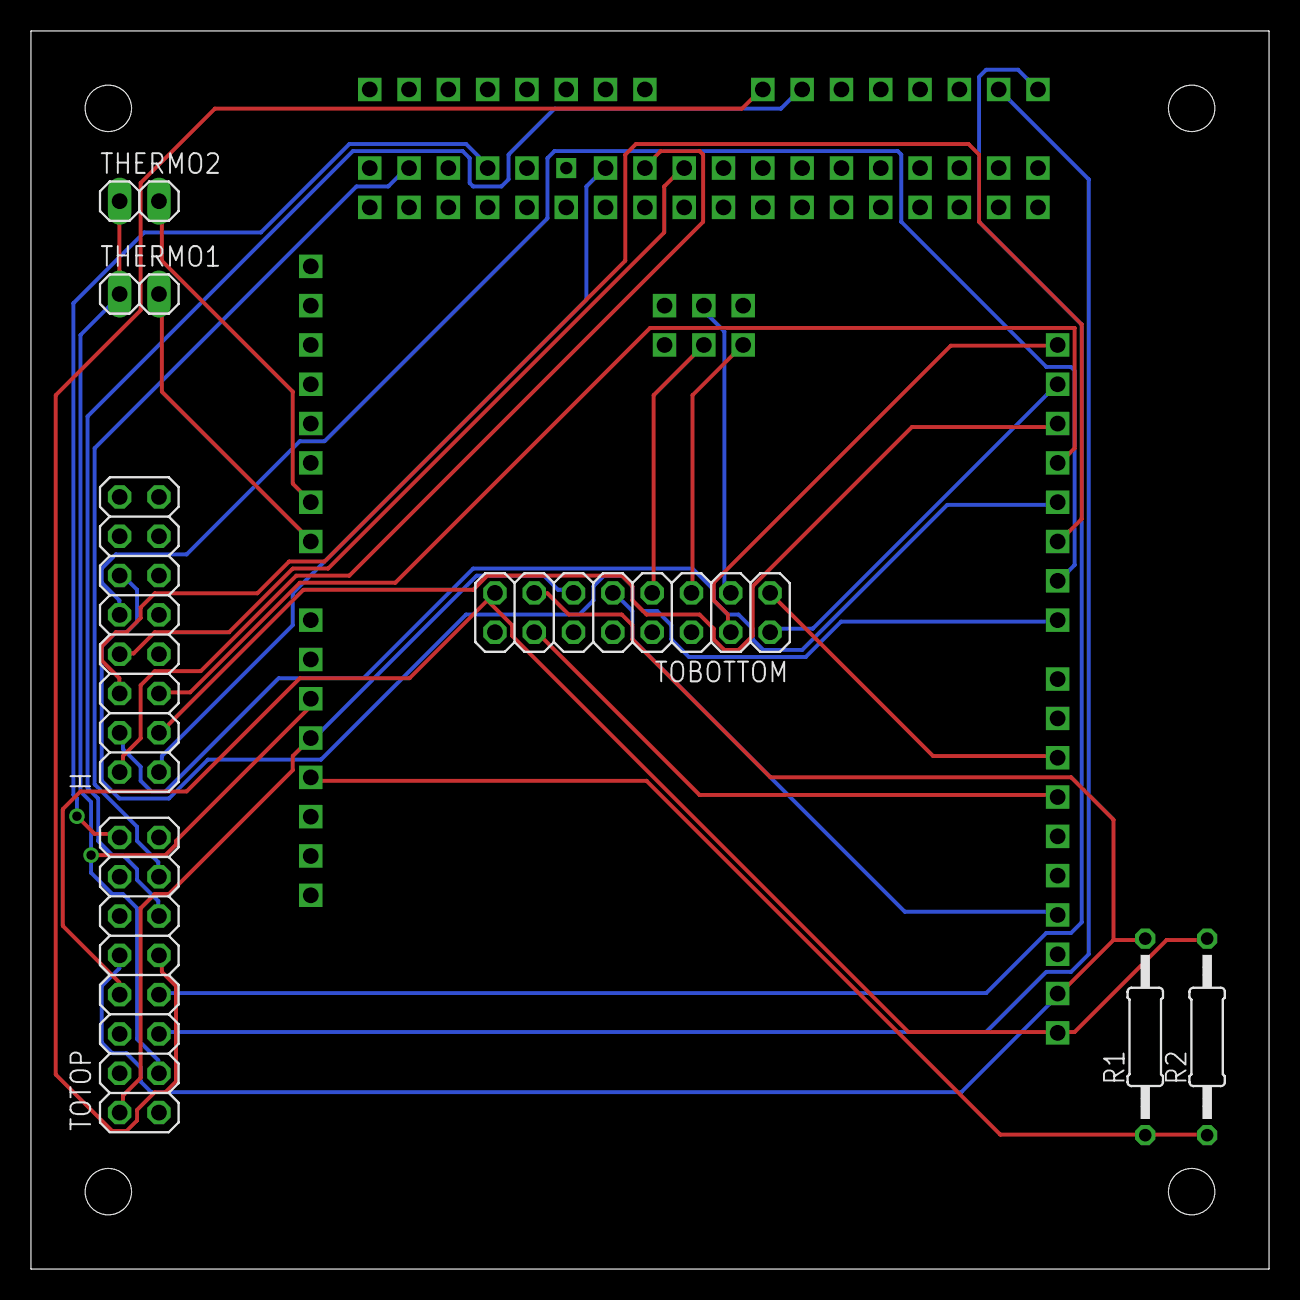
[picture p118: board mcuboard.brd from above]

Board: 2 copper layers, 80.0 x 80.0 mm, 8 parts (1 on the bottom side), 30 nets.
