NikitaSardesai/AERO3760-Space-Engineering-2/Eagle/SnapSat/pmu.brd

## EAGLE design Eagle/SnapSat/pmu.brd (2015-10-19)

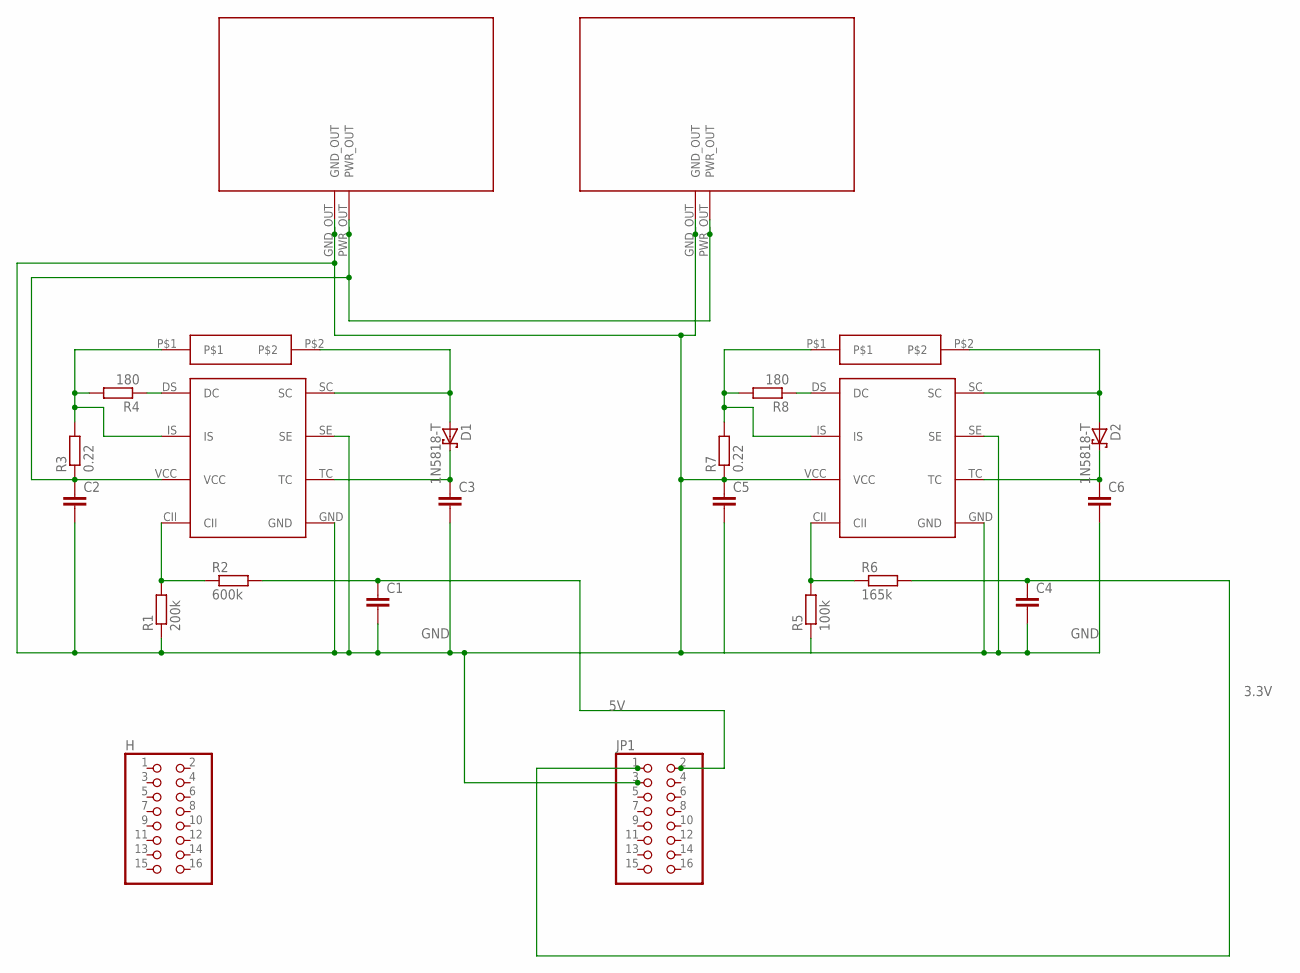
[picture p119: schematic pmu.sch]

Parts:
C1, C2, C3, C4, C5, C6: C2.5/6; C2.5-6
D1, D2: 1N5818-T; DO41-7.6
H: PINHD-2X8; 2X08
JP1: PINHD-2X8; 2X08
R1: 200k; 0207/12
R2: 600k; 0207/12
R3, R7: 0.22; 0207/12
R4, R8: 180; 0207/12
R5: 100k; 0207/12
R6: 165k; 0207/12
U$1, U$2: CHAR
U$3, U$5: TIBB
U$4, U$6: IND; 8RHT2

Connections:
3.3V: C4.1, JP1.1, R6.2
5V: C1.1, JP1.2, R2.2
GND: C1.2, C2.2, C3.2, C4.2, C5.1, C5.2, C6.2, JP1.3, R1.1, R5.1, R7.1, U$1.GND_OUT, U$2.GND_OUT, U$3.GND, U$3.SE, U$5.GND, U$5.SE, U$5.VCC
unnamed: D1.A, U$3.SC, U$4.P$2
unnamed: C2.1, R3.1, U$1.PWR_OUT, U$2.PWR_OUT, U$3.VCC
unnamed: R1.2, R2.1, U$3.CII
unnamed: R4.1, U$3.DS (DC)
unnamed: C3.1, D1.C, U$3.TC
unnamed: R5.2, R6.1, U$5.CII
unnamed: R3.2, R4.2, U$3.IS, U$4.P$1
unnamed: R7.2, R8.2, U$5.IS, U$6.P$1
unnamed: R8.1, U$5.DS (DC)
unnamed: D2.A, U$5.SC, U$6.P$2
unnamed: C6.1, D2.C, U$5.TC

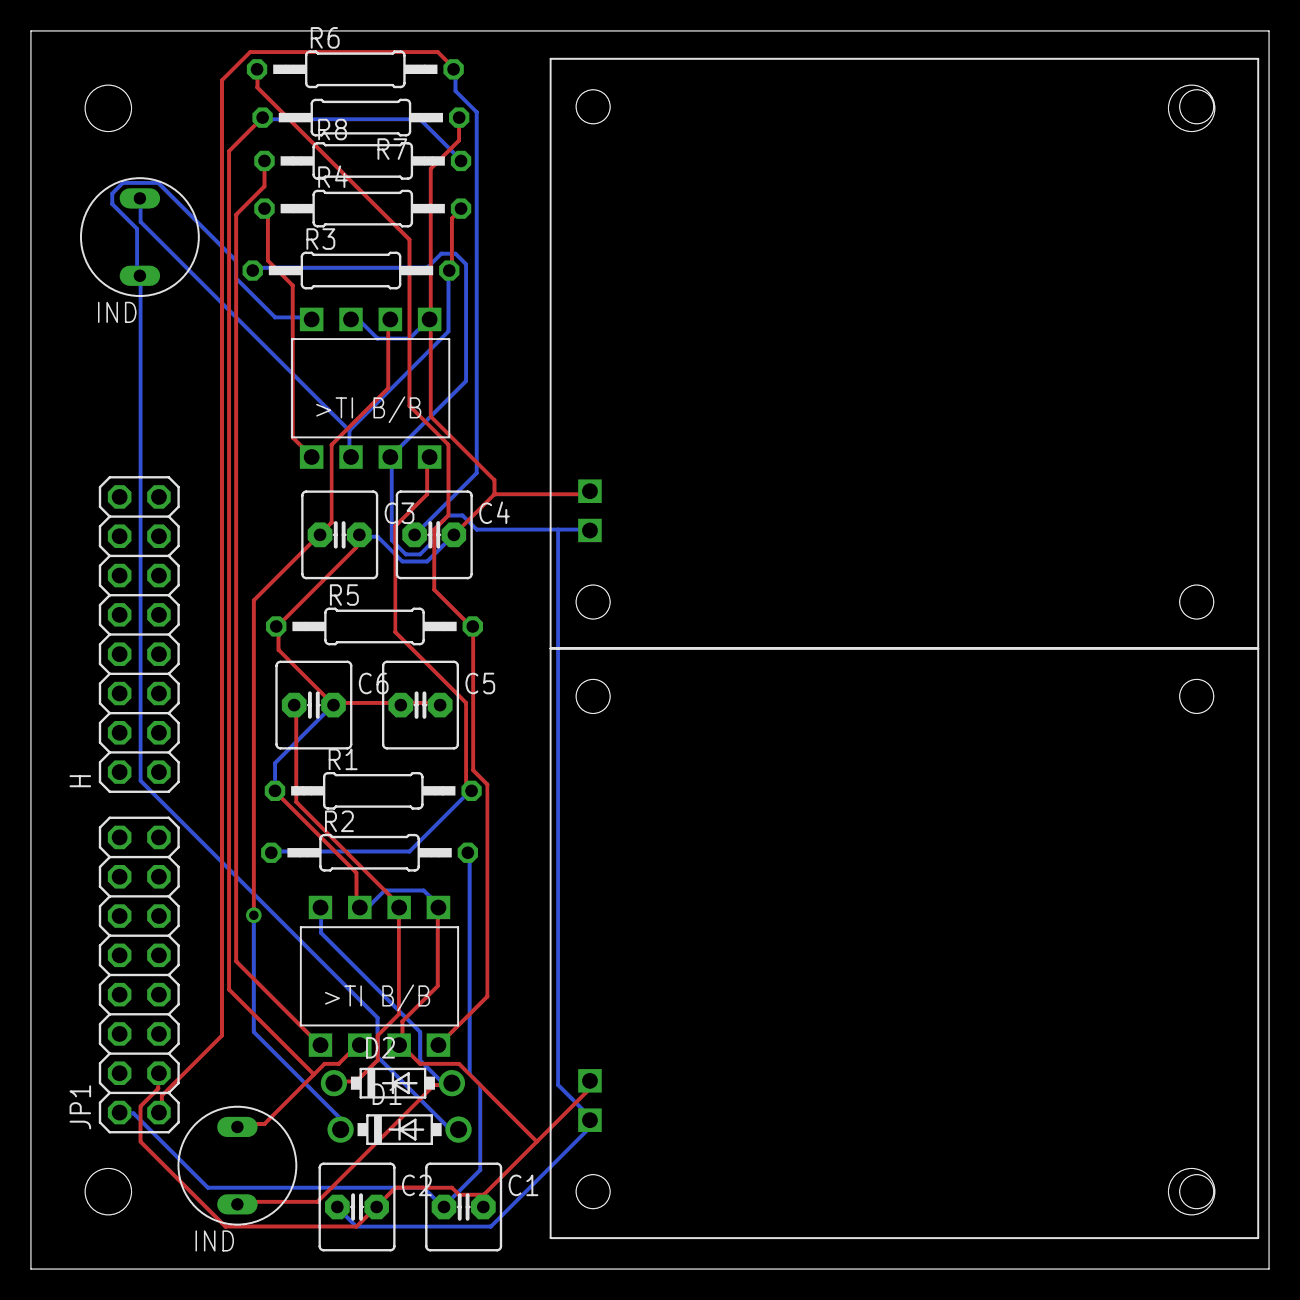
[picture p120: board pmu.brd from above]

Board: 2 copper layers, 80.0 x 80.0 mm, 24 parts (0 on the bottom side), 14 nets.
