NikitaSardesai/AERO3760-Space-Engineering-2/Eagle/SnapSat/posboard.brd

## EAGLE design Eagle/SnapSat/posboard.brd (2015-10-19)

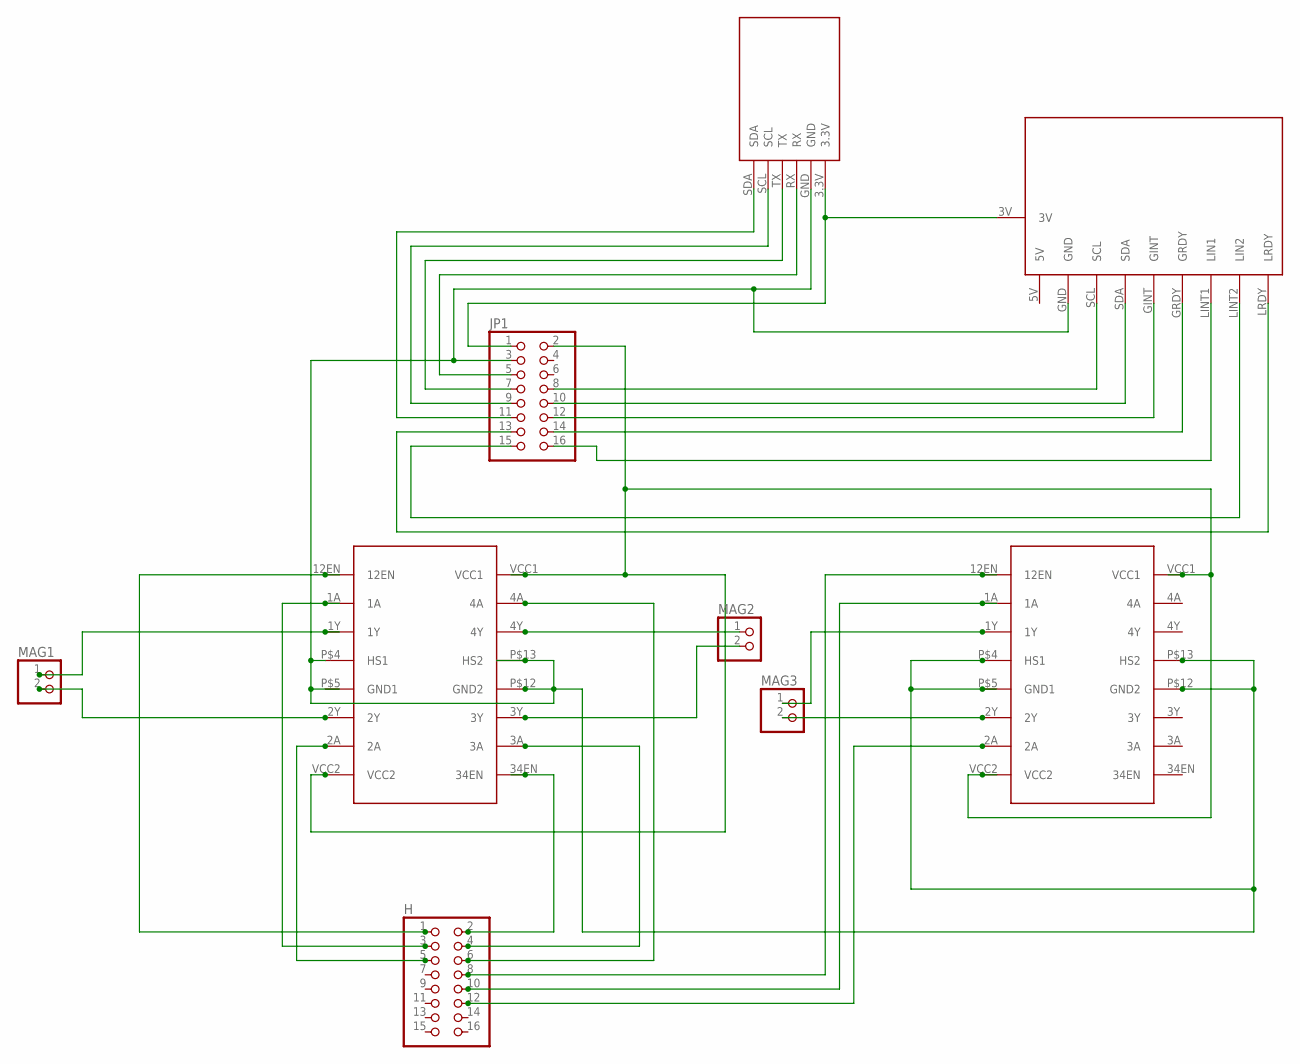
[picture p121: schematic posboard.sch]

Parts:
H: PINHD-2X8; 2X08
JP1: PINHD-2X8; 2X08
MAG1, MAG2, MAG3: PINHD-1X2; 1X02
U$1: GPS
U$2: IMU
U$3, U$4: HBRIDGE

Connections:
unnamed: JP1.1, U$1.3.3V, U$2.3V
unnamed: JP1.3, U$1.GND, U$2.GND, U$3.P$4 (HS1), U$3.P$12 (GND2), U$3.P$13 (HS2), U$4.P$4 (HS1), U$4.P$5 (GND1), U$4.P$12 (GND2), U$4.P$13 (HS2)
unnamed: JP1.5, U$1.RX
unnamed: JP1.7, U$1.TX
unnamed: JP1.9, U$1.SCL
unnamed: JP1.11, U$1.SDA
unnamed: H.1, U$3.12EN
unnamed: JP1.13, U$2.LRDY
unnamed: JP1.15, U$2.LINT2 (LIN2)
unnamed: JP1.16, U$2.LINT1 (LIN1)
unnamed: JP1.14, U$2.GRDY
unnamed: JP1.12, U$2.GINT
unnamed: JP1.10, U$2.SDA
unnamed: JP1.8, U$2.SCL
unnamed: H.3, U$3.1A
unnamed: JP1.2, U$3.VCC1, U$3.VCC2, U$4.VCC1, U$4.VCC2
unnamed: H.2, U$3.34EN
unnamed: H.4, U$3.3A
unnamed: H.5, U$3.2A
unnamed: H.8, U$4.12EN
unnamed: H.10, U$4.1A
unnamed: H.6, U$3.4A
unnamed: H.12, U$4.2A
unnamed: MAG1.1, U$3.1Y
unnamed: MAG1.2, U$3.2Y
unnamed: MAG2.1, U$3.4Y
unnamed: MAG2.2, U$3.3Y
unnamed: MAG3.1, U$4.1Y
unnamed: MAG3.2, U$4.2Y

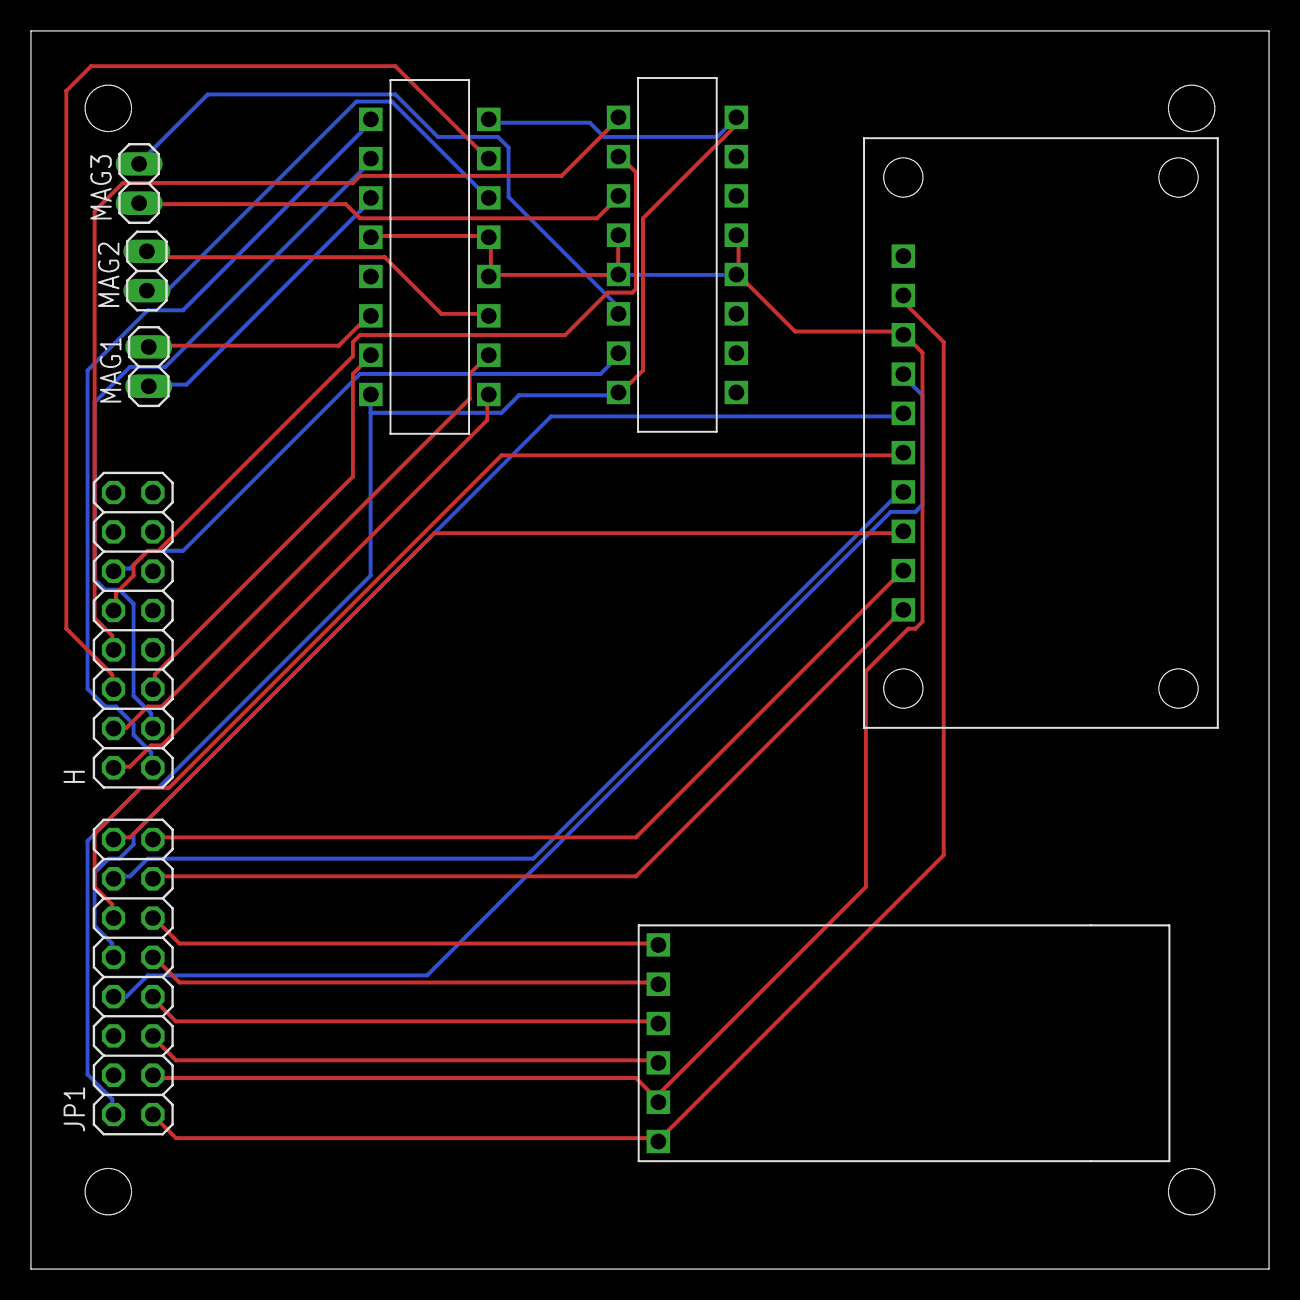
[picture p122: board posboard.brd from above]

Board: 2 copper layers, 80.0 x 80.0 mm, 9 parts (0 on the bottom side), 29 nets.
