NikitaSardesai/AERO3760-Space-Engineering-2/Eagle/SnapSat/bottomboard.brd

## EAGLE design Eagle/SnapSat/bottomboard.brd (2015-10-19)

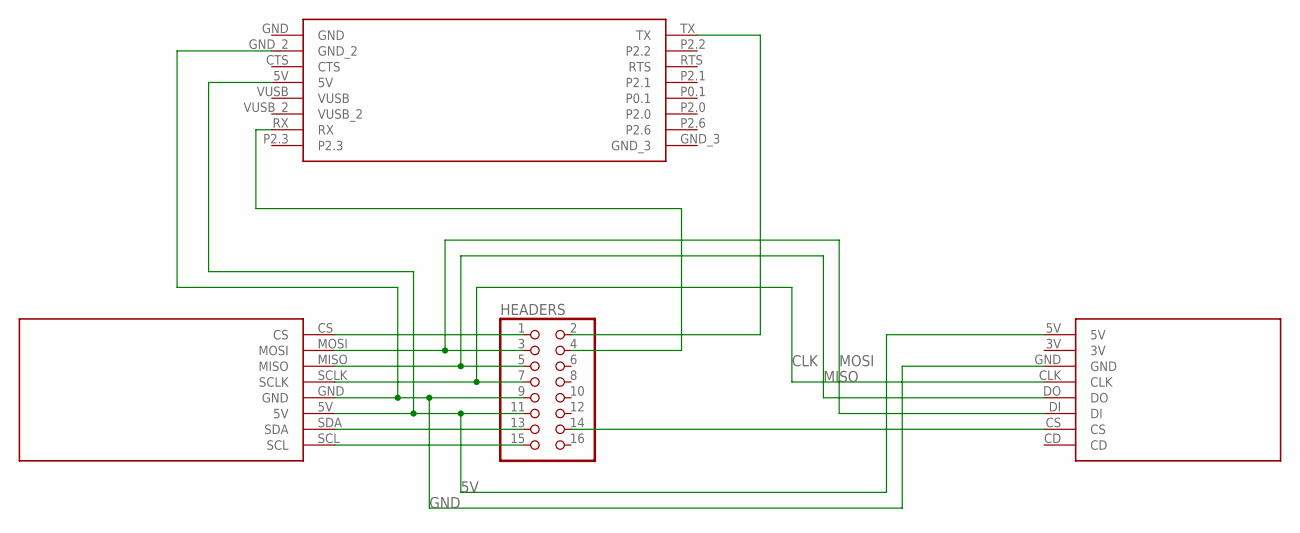
[picture p123: schematic bottomboard.sch]

Parts:
HEADERS: PINHD-2X8; 2X08
U$1: COMMS
U$2: SDCARD
U$3: ARDUCAM

Connections:
5V: HEADERS.11, U$1.5V, U$2.5V, U$3.5V
CLK: HEADERS.7, U$2.CLK, U$3.SCLK
GND: HEADERS.9, U$1.GND_2, U$2.GND, U$3.GND
MISO: HEADERS.5, U$2.DO, U$3.MISO
MOSI: HEADERS.3, U$2.DI, U$3.MOSI
unnamed: HEADERS.1, U$3.CS
unnamed: HEADERS.14, U$2.CS
unnamed: HEADERS.2, U$1.TX
unnamed: HEADERS.4, U$1.RX
unnamed: HEADERS.13, U$3.SDA
unnamed: HEADERS.15, U$3.SCL

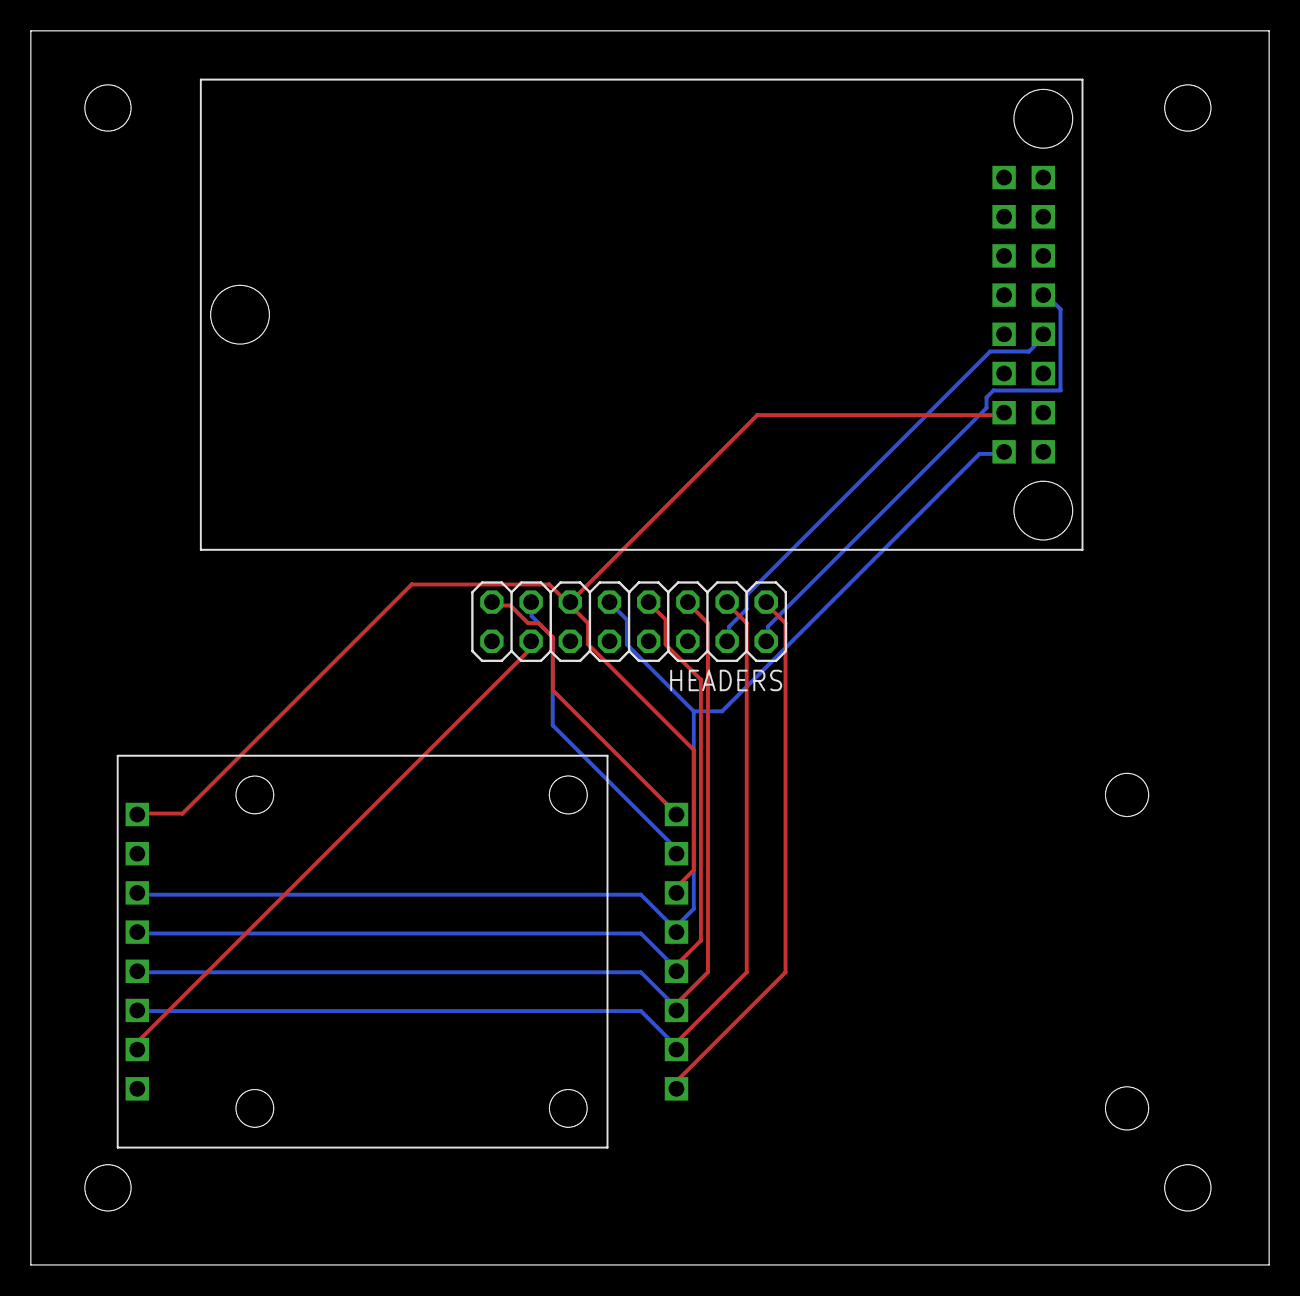
[picture p124: board bottomboard.brd from above]

Board: 2 copper layers, 80.3 x 80.0 mm, 4 parts (1 on the bottom side), 11 nets.
