NikitaSardesai/AERO3760-Space-Engineering-2/(commit log)

2015-08-15 Updated Payload Design Overview
    [Mass Balance.xlsx]
2015-08-20 Budgets upload
    [Budgets.xlsx]
2015-08-20 Changes to ADCS masses
    [Budgets.xlsx]
2015-08-20 Initial commit of Aluminium 6061 structure design
    [Assem1.SLDASM, connectors.SLDDRW, connectors.SLDPRT, top.SLDDRW, top.SLDPRT, walls.SLDDRW]
2015-08-20 budgets
    updated budgets, slight concern about power draw of camera - will ask
    D. Rye about it tomorrow
    [Budgets.xlsx]
2015-08-21 Change to Power Requirements for Magnetorquers
    [Budgets.xlsx]
2015-08-22 Just added a couple of things
2015-08-23 Power
    finished Power Budget, finalized modes of operations
2015-08-23 budgets
    updated budgets
    [Budgets.xlsx]
2015-08-23 minor changes
    budgets
    [Budgets.xlsx]
2015-08-26 Folder reorganisation
    [Budgets.xlsx, Mass Balance.xlsx, Shopping List.xlsx]
2015-08-27 updated shopping list
    [Shopping List.xlsx]
2015-08-30 quick update
    [Shopping List.xlsx]
2015-08-30 Added Annex document
    [Annex 1 CubeSat_Overview_Spreadsheet.xlsx, Shopping List 1.xlsx]
2015-08-31 Updated Annex
    [Annex 1 CubeSat_Overview_Spreadsheet.xlsx]
2015-09-07 final annex
    [Annex 1 CubeSat_Overview_Spreadsheet.xlsx]
2015-09-07 final final annexe
    [Annex 1 CubeSat_Overview_Spreadsheet.xlsx]
2015-09-12 CDR report beginning
    general outline for the CDR, starting to put all my thermal stuff in.
    Will also write a but about the payload.
    NoteL there are two other documents we also need to submit - will get
    started on these too
    [Annex 1 SnapSat_Overview_Spreadsheet.xlsx]
2015-09-15 PCB layouts
    pcblayout
    [Assembly.SLDASM, Batteries4.SLDPRT, Board.SLDPRT, BottomBoard.SLDPRT, Box.SLDPRT, IduinoBoard.SLDPRT, IduinoBoardAngle.SLDPRT, LocBoard.SLDPRT]
2015-09-23 Added the template of the code we will be using. It has some timer interrupts that all called utilising the library that is provided and an example hardware interrupt.
2015-09-24 parsolid parts, might be able to open
    [Assembly.x_t, Batteries4.x_t, Board.x_t, BottomBoard.x_t, Box.x_t, IduinoBoard.x_t, IduinoBoardAngle.x_t, LocBoard.x_t]
2015-09-24 update on pcb
2015-10-05 updates and thermal
    [bottomboard.brd, bottomboard.sch, mcuboard.brd, mcuboard.sch, pmu.brd, pmu.sch, posboard.brd, posboard.sch]
2015-10-12 eagle files 2
    [bottomboard.brd, bottomboard.sch, mcuboard.brd, mcuboard.sch, pmu.brd, pmu.sch, posboard.brd, posboard.sch]
2015-10-15 Magnotorquers code
    This has the code for running the magnotorquer section. It takes the
    current location and desired location and outputs to the magnotorquers.
    We still need to write the comms code and mag code but imu is done
2015-10-15 IMU data and libraries
    Added imu stuff to interruptcode
    Added libraries that you will need to install to run code
2015-10-18 logging
    not interrupts, no timelog
2015-10-19 fixed known pcb issues, small magnotorquer changes
    [bottomboard.brd]
2015-10-19 actual fixed pcbs
    [Arduino-DUE-V03.brd, Arduino-DUE-V03.sch, bottomboard.brd, bottomboard.sch, mcuboard.brd, mcuboard.sch, pmu.brd, pmu.sch]
2015-10-19 extra breakouts
    [mcuboard.brd, mcuboard.sch]
2015-10-28 integration
    integrated to pcbs arducam to sd card
2015-10-29 PID Library and Integrated Code
2015-10-30 Link budgets added
    [Annex 1 SnapSat_Overview_Spreadsheet.xlsx]
2015-10-30 ANNEX UPDATE
    [Annex 1 SnapSat_Overview_Spreadsheet.xlsx]
2015-11-04 CDR changes
    [Shopping List 1.xlsx, Shopping List.xlsx]
2015-11-08 Added IMU libraries
2015-11-23 IMU code
